MichalBiro/Bachelor-thesis/README.md

# Bachelor-thesis

This repository serves for storing and sharing my bachelor thesis files.

DipTrace
- in this folder you can find schemes for my hardware PCBs made in CAD software DipTrace

Latex
- this folder contains all files of wich consists my Bachelor thesis.
- look for Zaverečná_práca.pdf to read my thesis
