MichalBiro/Bachelor-thesis/Latex/Obalka.tex

\renewcommand\thepage{\roman{page}}
\pagenumbering{roman}
\thispagestyle{empty}

\noindent \begin{center}
	\textbf{{\large{}SLOVENSKÁ TECHNICKÁ UNIVERZITA V BRATISLAVE}}\\
	\textbf{{\large{}STROJNÍCKA FAKULTA}}\textbf{\large{} }\\
	\vspace{3cm}
	\par\end{center}

\noindent \begin{center}
	\vspace{3cm}
	\par\end{center}

\begin{center}
	\textbf{\textsc{\Large{}BoBShield: Miniaturizovaný experiment „guľôčka na tyči“}}\\
	\par\end{center}{\Large \par}

\begin{center}
	\textbf{\large{}Bakalárska práca}\\
	\par\end{center}{\large \par}

\begin{center}
	{\large{}SjF-13432-104853}\\
	\par\end{center}{\large \par}

\vfill
\noindent \textbf{\large{}2022} \hfill \textbf{\large{}Michal Bíro}
\cleardoublepage
