MichalBiro/Bachelor-thesis/Latex/Zaverečná práca.pdf

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

Názov práce: Miniaturizovaný experiment "gu©ô£ka na ty£i"
K©ú£ové slová: - Arduino, ToF, servomotor gu©ô£ka na ty£i, riadenie Abstrakt: Cie©om bakalárskej práce je vylep²enie existujúceho zariadenia BOBShield, ktoré reprezentuje experiment s názvom gulô£ka na ty£i a je sú-£as´ou projektu AutomationShield. V prvej kapitole rozoberá samotný experiment a opisuje pôvodné verzie zariadenia. V druhej kapitole hovorí o zmenách, ktoré sme na zariadení vykonali, vysvet©uje dôvody, pre£o sme sa pre dané zmeny rozhodli a ukazuje výsledný model ná²ho zariadenia. V poslednej kapitole sa venuje softvérovej £asti zariadenia, kde hovorí o API v programoch Simulink a Arduino IDE, ktoré sme pre zariadenie upravili alebo vytvorili a príkladoch, ktoré sme testovali na novom hardvéry. V závere hovorí o priestore na zlep²enie daného zariadenia v budúcnosti.

Title: Force measurement by strain gauges
Keywords: - Arduino, ToF, servomotor, ball on beam, control
Abstract: The aim of this bachelor thesis is to improve the existing BOBshield device, which represents an experiment called ball on beam and is part of the AutomationShield project. In the rst chapter analyze the experiment itself and describes older versions of the device. In next chapter talks about the changes we have made to the device, explains the reasons for their implementation and shows the nal model of our device. The last chapter deals with the software of device, which consists of APIs made in programming environments Simulink and Arduino IDE and examples made in these environments, which were tested on the new hardware. At the end it talks about possible improvements that can be made to the device in the future and outcomes of this thesis.

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

## Úvod

Oblas´ automatizácie a automatického riadenia sa rýchlo rozvíja a v modernom svete má ve©ké zastúpenie v oblasti výroby. Vo svete sú £oraz viac vyuºívané automatické výrobné linky, prevádzky a závody, práve kvôli zvy²ovaniu produktivity a redukciou vznikajúcich chýb vo výrobe. Aby mohol rozvoj napredova´ je potrebné pre danú oblas´ podporova´ vzdelávanie budúcich technikov a vedcov. Práve kvalita vzdelávania sa totiº výrazne odrazí v nasledujúcich rokoch ich práce.
Hoci dôleºitou £as´ou vzdelávania je práve teória riadenia, s ktorou sa ²tudenti univerzít stretávajú na predná²kach, platí, ºe £lovek si najviac zapamätá, ke¤ si to môºe aj vyskú²a´ v praxi. Nie kaºdý má v²ak túto moºnos´ a nie kaºdá univerzita disponuje rovnako vybavenými laboratóriami. Preto je pre mnohých niekedy takmer nemoºné stretnú´ sa po£as ²túdia s praxou a to hlavne v £asoch, kedy sa ²tudenti nemôºu zú£astni´ prezen£nej vzdelávacej formy. Absencia praktických ukáºok môºe ma´ za následok neskor²ie problémy pri prechode ²tudentov na pracovný trh.
AutomationShield so svojimi zariadeniami priná²a jednoduché rie²enie tohto problému, kedy tvorbou zariadení minimálnych rozmerov a nákladov, poskytuje ²tudentom moºnos´ vyskú²a´ si riadenie systému v praxi. V¤aka svojej cene nie sú pre ²kolu tieto zariadenia nan£ne náro£né a svojimi ²ikovnými rozmermi poskytujú ²tudentom moºnos´ pracova´ na nich aj z domova., £o je viac ako vítané pri di²tan£nej forme ²túdia. Momentálne sa v projekte nachádza 11 zariadení a BOBShield je jedným z nich. Zariadenie uº pre²lo ur£itým vývojom a momentálne existujú 2 verzie. Hoci pri druhom zariadení pri²lo ku viacerým zmenám a vylep²eniam oproti prvej verzii, stále poskytuje priestor na vylep²enie. Cie©om práce bolo opä´ urobi´ analýzu zariadenia a prís´ s nápadmi na vylep²enie, £i uº hardvéru alebo softvéru. V oblasti softvéru i²lo o vývoj API v programovacom prostredí Simulink a tvorba príkladu na riadenie systému. Pri hardvéry sme sa zamerali na pouºité komponenty, kde sme h©adali ich varianty, nachádzajúce sa na trhu a analyzovali sme ako by ich zmena vplývala na chod zariadenia.
Túto tému som si vybral hlavne z dôvodu . Tieº povaºujem celú my²lienku AutomationShieldu ve©mi efektívnu a praktickú. Pá£i sa mi snaha poskytnú´ ²tudentom priestor pre rozvoj a vzdelávanie nie len v teoretickej rovine ale aj v praxi. Hoci ide o v princípe jednoduché zariadenia, kaºdé má ve©ký potenciál a proces vývoja a vylep²ovania jednotlivých verzií a prevedení so sebou priná²a taktieº drahocenné skúsenosti a vedomosti.

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

mov. Medzi programy vyuºívané pre tvorbu API - rozhraní pre programovanie aplikácií patrí v základe Arduino IDE, MATLAB a Simulink.

## 1.2 Experiment - Gulô£ka na ty£i

Guli£ka na ty£i po anglicky Ball on Beam, odkia© pochádza aj názov ná²ho zariadenie, je dynamický systém, ktorý pozostáva z dlhej ty£e pripojenej k servomotoru, ktorá sa jeho pôsobením naklá¬a a guli£ky, ktorá sa pohybuje po ty£i dopredu a dozadu, v závislosti od jej naklonenia. Ide o ve©mi populárny príklad pouºívaný pri výu£be teórie riadenia. Guli£ka na ty£i je teda nestabilný, nelineárny systém s otvorenou slu£kou. Aj pri malej výchylke trubi£ky sa guli£ka skotú©a do jednej z krajných polôh ty£e. Stabilizáciu guli£ky v ur-£itej pozícii je potrebný riadiaci systém, ktorý meria polohu guli£ky na ty£i a na základe získaných hodnôt vyhodnocuje nastavenie polohy ty£e. Na obrázku 1.1 môºeme vidie´ parametre systému, kde zmena uhla θ pôsobí cez rameno páky na ty£ a spôsobí jej oto£enia o uhol α. Ke¤ sa zmení uhol z horizontálnej pozície, gravitácia zaprí£iní pohyb guli£ky po ty£i. Úlohou riadiaceho systému je teda aby sme vedeli ovláda´ pozíciu guli£ky.

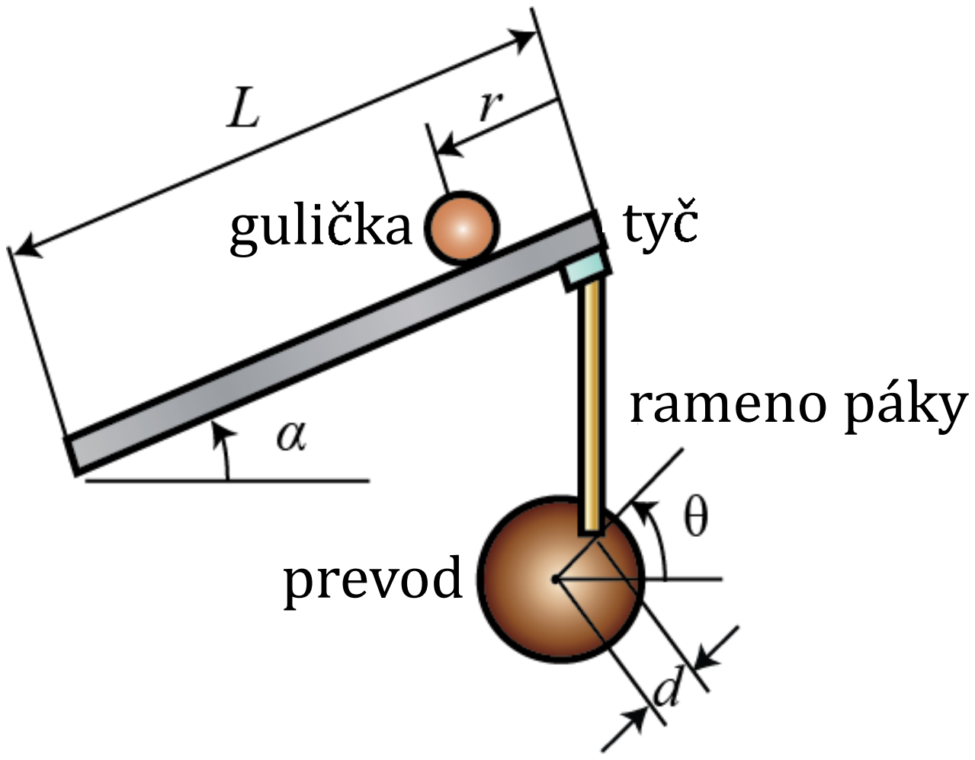
[picture p4: figure]
guli ka; rameno páky; prevod

Obr. 1.1: Systém guli£ka na ty£i [5]

Ná² systém sa od systému na obrázku mierne lí²i. Namieste ty£e sa guli£ka pohybuje uprostred trubi£ky a jej stred otá£ania sa nenachádza na konci trubi£ky ako to môºeme vidie´ na obr. 1.1. Uloºená je v drºiaku, ktorý sa nachádza v jej strede a práve pomocou neho je na ¬u prená²aný krútiaci moment zo servomotora. V pôvodnej verzii sa teda nenachádzal ani prevod spomenutý na obrázku, drºiak bol priamo pripevnený k servomotoru. Prevod sme v²ak pri vylep²ovaní hardvéru zahrnuli do jeho zmien, no oproti klasickému rie²eniu uvedenému na obrázku sme zvolil ná² vlastný originálny prístup. Výhodnou tohto spôsobu zostavenia systému sú jeho rozmery, sú dostato£ne malé aby sme vedeli celý model uloºi´ na Arduino shield.

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

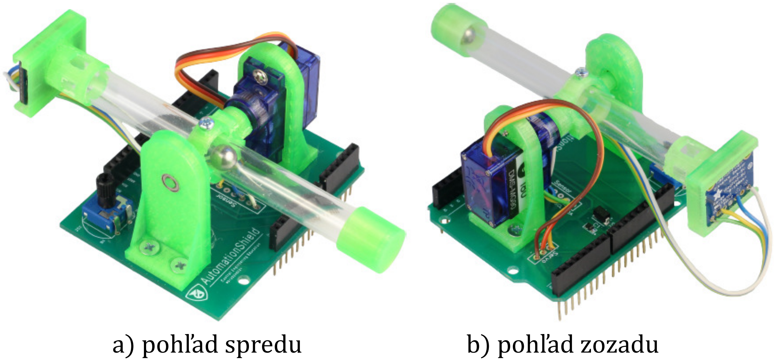
[picture p5: figure]
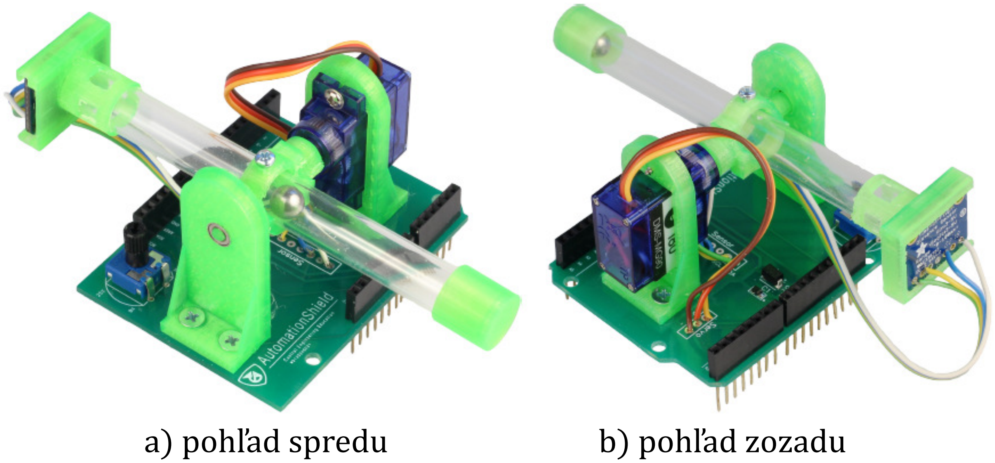
[picture p6: figure]

vytvorené API (aplika£né programovacie prostredie) len v prostredí Arduino IDE. Pozostáva z kniºnice BOBShield.h a nieko©kých príkladov ako je regulácia alebo identikácia systému. To ponúka priestor pre tvorbu nových API v uº spomenutých programovacích prostrediach.

### 1.3.2 R2 hardvér

Z h©adiska hardvéru ponúka verzia R2 priestor pre analýzu pouºitých komponentov a ich porovnanie s novými moºnos´ami ponúkanými na trhu. Tieº je moºné zvý²enie presnosti otá£ania trubi£ky o implementáciou uº spomínaného prevodu medzi servomotorom a drºiakom trubi£ky. Z toho následne vyplýva aj zmena 3D prvkov a celkového dizajnu zariadenia.

## 2 R3 hardvér

Nasledujúca kapitola je venovaná vyhotoveniu zariadenie z poh©adu hardvéru. Hovorí o £astiach, z ktorých sa zariadenie skladá, o ich parametroch, funkciách a vlastnostiach. Taktieº porovnáva poslednú verziu vyhotovenia verzia R3, so star²ími verziami zariadenia, vysvet©uje, pre£o sme sa pre dané zmeny rozhodli a ako vplývajú na celkové fungovanie zariadenia. Medzi výraznej²ie zmeny patrí napríklad implementácia nového sníma£a - gyroskopa alebo nový typ prevodového systému. Kapitola najprv vysvet©uje schému zapojenia ná²ho zariadenia, neskôr detailnej²ie opisuje jednotlivé komponenty, z ktorých sa zariadenie skladá. Tieº opisuje výber vhodného telesa pre ná² systém, implementáciu nového spôsobu prevodu rota£ného pohybu zo servomotora na trubi£ku a tvorbu nových 3D prvkov. V závere sa nachádza zoznam v²etkých komponentov a sú£iastok, z ktorých sa zariadenie skladá a hovorí o jeho výslednej cene.

## 2.1 Schéma zapojenia

Schéma zapojenia ná²ho zariadenia pre²la od poslednej verzie nieko©kými zmenami. Celkovo by sa dala rozdeli´ na 2 oddelené schémy, ktoré sú vzájomne prepojené pomocou FFC (at exible cable) káblu. Oddelenie schém je potrebné z dôvodu, ºe senzory na snímanie polohy guli£ky v trubi£ke a pooto£enia ramena musia by´ umiestnené na trubi£ke. Z toho vyplýva ºe schéma celého na²eho zariadenia musí by´ oddelená aby mohli by´ vytvorené 2 PCB dosky, ktoré v celku tvoria jednu schému. Prvou je £as´ zariadenia nachádzajúca sa na hlavnej PCB doske (obr. 2.1 ), ktorú priamo zapájame do Arduina. Obsahuje servomotor (a) , ktorý je napájaný 5 V a je pripojený k arduinu () prostredníctvom pinu 9, cez ktorý prijíma od arduina PWM signál, potrebný na riadenie polohy oto£enia jeho hriade©a. K servomotoru je pripojený aj kondenzátor
(g) a dióda (j). Úlohou kondenzátora je vyhladi´ prechodové javy, ktoré by mohli ovplyvni´ napájanie serva a dióda slúºi ako ochrana pred po²kodením obvodov spätným EMF elektromotorickým napätím. Potenciometer (c) je napájaný napätím 3,3 V a k arduinu je pripojený pomocou analógového pinu A0, ktorý slúºi na získavanie hodnôt, ktoré neskôr transformujeme do formy, v ktorej môºu by´ pouºité ako referen£ná hodnota pre riadenie polohy. Zmenou v schéme zapojenia oproti poslednej verzii je implementácia lineárneho regulátora napätia LDO (b), potrebného pre zmenu hladiny napätia pre napájanie sníma£ov. Je pripojený k zdroju napätia o ve©kosti 5V, ktorého hladinu upravuje a uº zmenenú posiela na konektor pre FFC kábel (d). Ten slúºi na

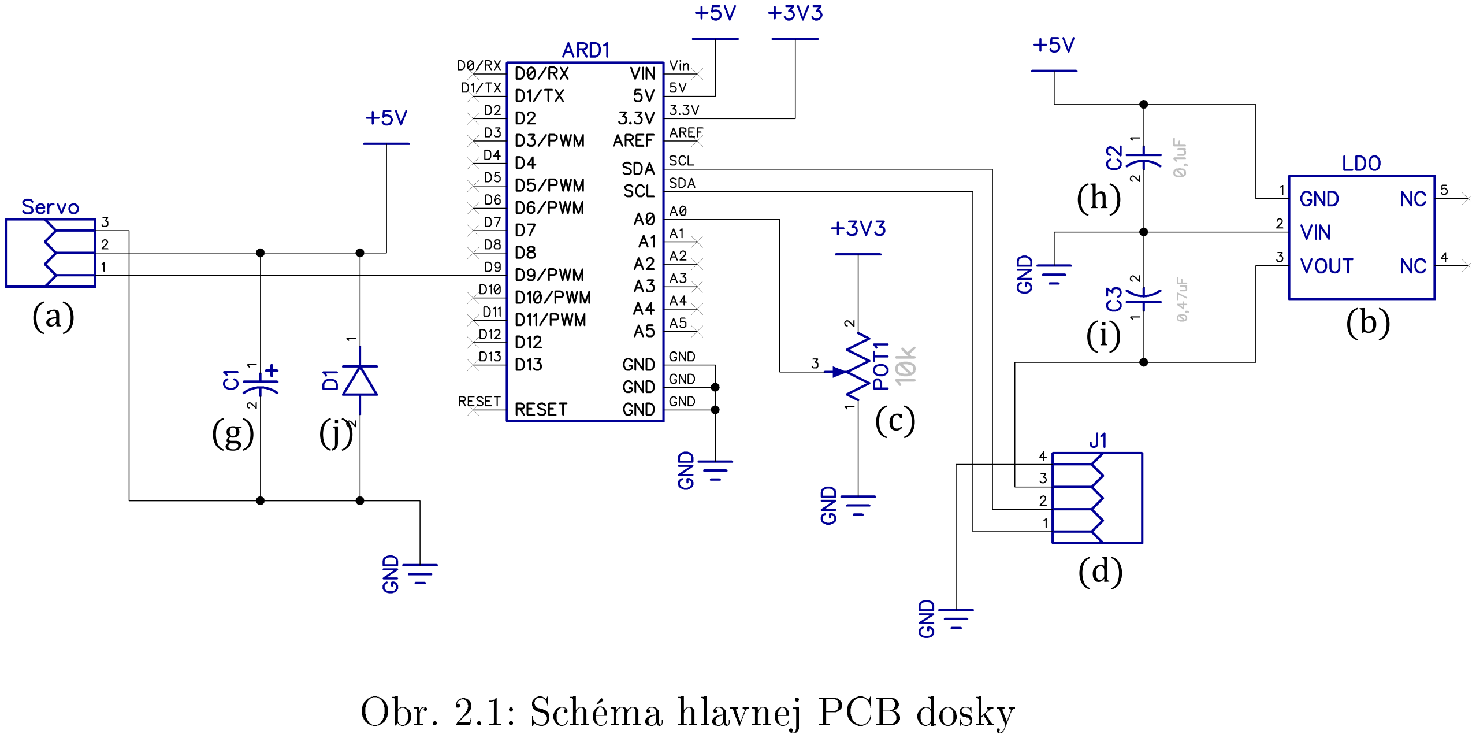
[picture p7: figure]
(j)Obr. 2.1: Schéma hlavnej PCB dosky

prepojenie jednotlivých schém do jedného celku. Je pripojený k pinom SCL a SDA na arduine, ktoré slúºia na sprostredkovanie I2C komunkácie. Ku LDO sú paralelne pripojené 2 kondenzátory (h) (i), ktoré sú na základe informácii z datasheetu [] potrebné pre fungovanie LDO a ich parametre sú pre daný lineárny regulátor napätia zadané.
Druhá £as´ schémy (obr. 2.2 ) je nami navrhnutá breakout doska, nachádzajúca sa na konci trubi£ky a obsahuje na²e sníma£e. Sníma£ polohy VL6180X
(e) je pripojený ku konektoru (d), ktorý mu poskytuje napájacie napätie a taktieº sprostredkováva I2C komunikáciu medzi sníma£om a arduinom. Gyroskop MPU-6050 (f) je rovnako ako sníma£ polohy napájaný cez konektor (d) a taktieº je paralelne pripojený k 2 kondenzátorom (k) (l). Ich potreba vyplýva z informácii poskytnutých v datasheete [], kde je uvedený správny spôsob zapojenia sníma£a aj parametre kondenzátorov. Rezistory (m) (n) slúºia ako pull up rezistory pri I2C komunikácii sníma£ov s arduinom.
Obe schémy boli navrhnuté vo vo©ne dostupnom software DIPTrace.
Po návrhu schémy zapojenia jednotlivých dosiek sme pristúpili k ich fyzickému návrhu. Pri tvorbe hlavnej PCB dosky sme museli pracova´ s tvarom dosky shieldu pre arduino, na ktorú sme sa snaºili vhodne umiestni´ jednotlivé komponenty a konektory. Na hlavnej doske (obr.2.3 a obr.2.4) sa okrem elektronických komponentov budú nachádza´ aj 3D prvky zariadenia, preto treba po£íta´ aj s ich umiestnením a vhodne zvoli´ diery ur£ené pre montáº týchto prvkov k doske (o). Na doske sa teda nachádza spoj pre pripojenie servomotora
(a) a potenciometer pre získavanie referen£nej hodnoty (c), ktorých umiestnenie sme nechali v rovnakej polohe ako pri pôvodnej verzii dosky. Ich poloha je vzh©adom na umiestnenie 3D prvkov ideálna, ke¤ºe konektor servomotora sa nachádza v dostato£nej blízkosti pre jeho pripojenie a zárove¬ nemusíme pouºi´ zbyto£ne dlhý kábel. Potenciometer sa tieº vzh©adom ku 3D modelu nachádza vo vhodnej pozícii, ke¤ºe jeho umiestnenie je ovplyvnené práve potrebou moºnosti pohybova´ s beºcom po£as chodu zariadenia. Preto je potrebné aby nedochádzalo k vzájomnej interakcii medzi pohyblivými £as´ami zariadenia

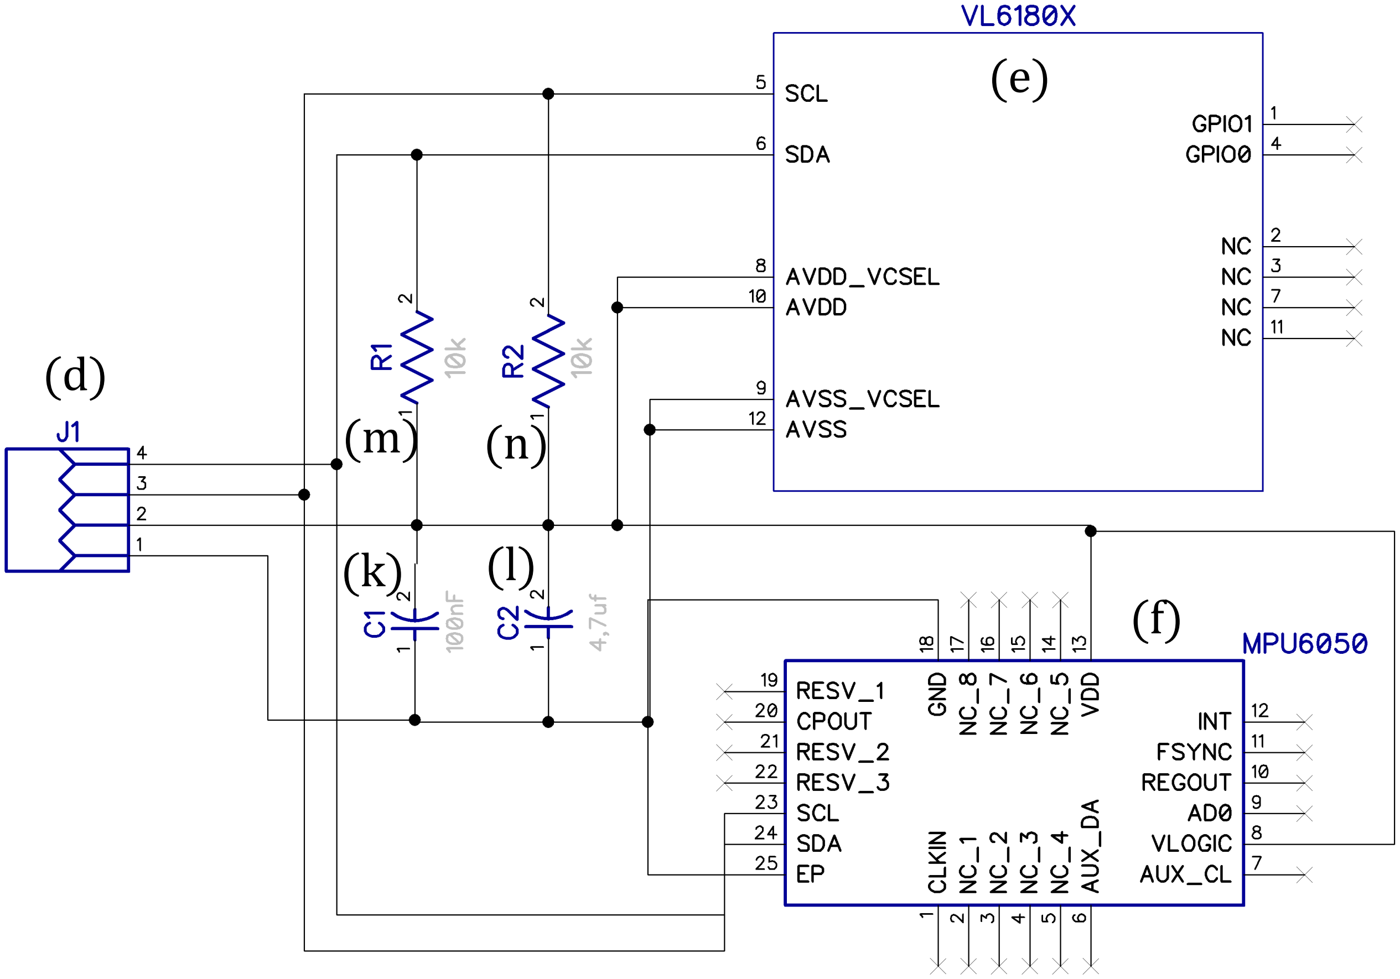
[picture p8: figure]

Obr. 2.2: Schéma PCB dosky so sníma£mi

a rukou uºívate©a pri nastavovaní referen£nej hodnoty. Umiestnenie kondenzátora (g) a diódy (i) je tieº pod©a pôvodnej verzii. Umiestnenie konektoru pre FFC káble (d) sme zvolili tak, aby sa po montáºi kompletného zariadenia nachádzal pod trubi£kou a tak nedochádzalo k jeho zahnutiu a sp¨¬alo to aj estetickú funkciu. Na základe jeho pozície do²lo k umiestneniu spoja pre LDO (b), ke¤ºe jeho úlohou je zmena hladiny napätia do rozsahu napájacích napätí sníma£ov, nachádza sa medzi konektorom FFC kábla (d) a zdrojom napätia z arduina. Kondenzátory (h) (i), na základe informácií z datasheetu [] potrebné pre fungovanie LDO, sú umiestnené v jeho tesnej blízkosti ako je odporú£ané. Pri návrhu PCB dosky ur£enej pre sníma£e (obr. 2.5), sme neboli obmedzení ºiadnym konkrétnym tvarom dosky, preto bolo na²im cie©om dosiahnu´ rozloºenie jednotlivých komponentov optimálnym spôsobom aby sme dosiahli £o najmen²ie rozmery. Na hornej £asti dosky môºeme nájs´ plo²ný spoj pre umiestnenie sníma£a MPU-6050 (f), konektor pre pripojenie FFC kábla (d) a jednotlivé komponenty (g) (h) (i) (j), ktorých implementácia vyplýva zo schémy zapojenia jednotlivých sníma£ov, ktorú je moºné nájs´ v datasheetoch []. Na spodnej strane PCB dosky sa nachádza spoj pre umiestnenie sníma£a VL6180X (e). Umiestnenie sníma£a na spodnej strane je z dôvodu aby smeroval do vnútra trubi£ky, v ktorej sa nachádza guli£ka. Po umiestnení PCB dosky do drºiaka na konci trubi£ky, sníma£ VL6180X smeruje do vnútra trubi£ky a z naopak FFC kábel smeruje von z trubi£ky, £o poskytuje jeho jednoduchú montáº.

## 2.2 Komponenty

Nasledujúca podkapitola detailnej²ie opisuje vlastnosti komponentov, s ktorými sme sa uº stretli pri schéme zapojenia. Hovorí o ich parametroch, funkciách, ktoré v zariadení zastre²ujú a tieº opisuje proces ich výberu a dôvod

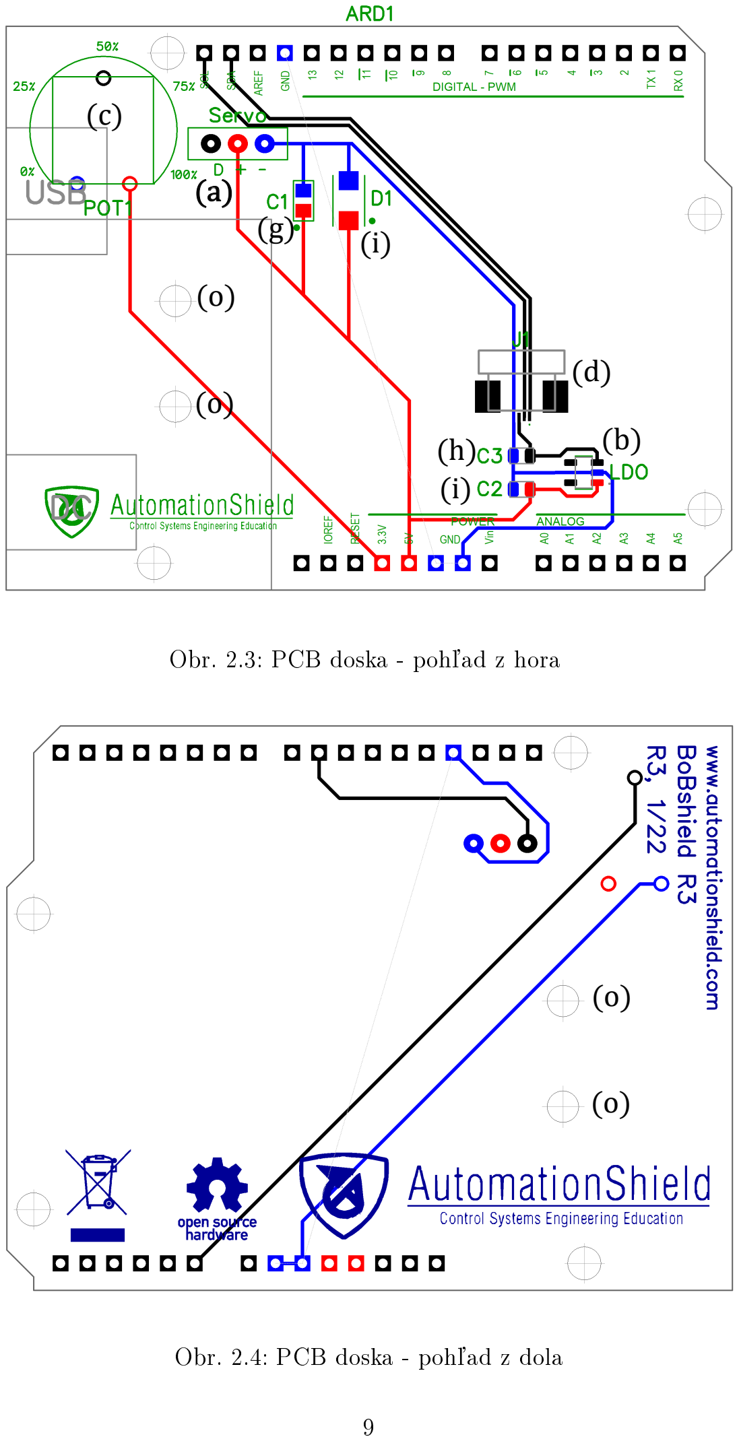
[picture p9: page 16]

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
Obr. 2.3: PCB doska - poh©ad z hora

(o)

(o)

Obr. 2.4: PCB doska - poh©ad z dola

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

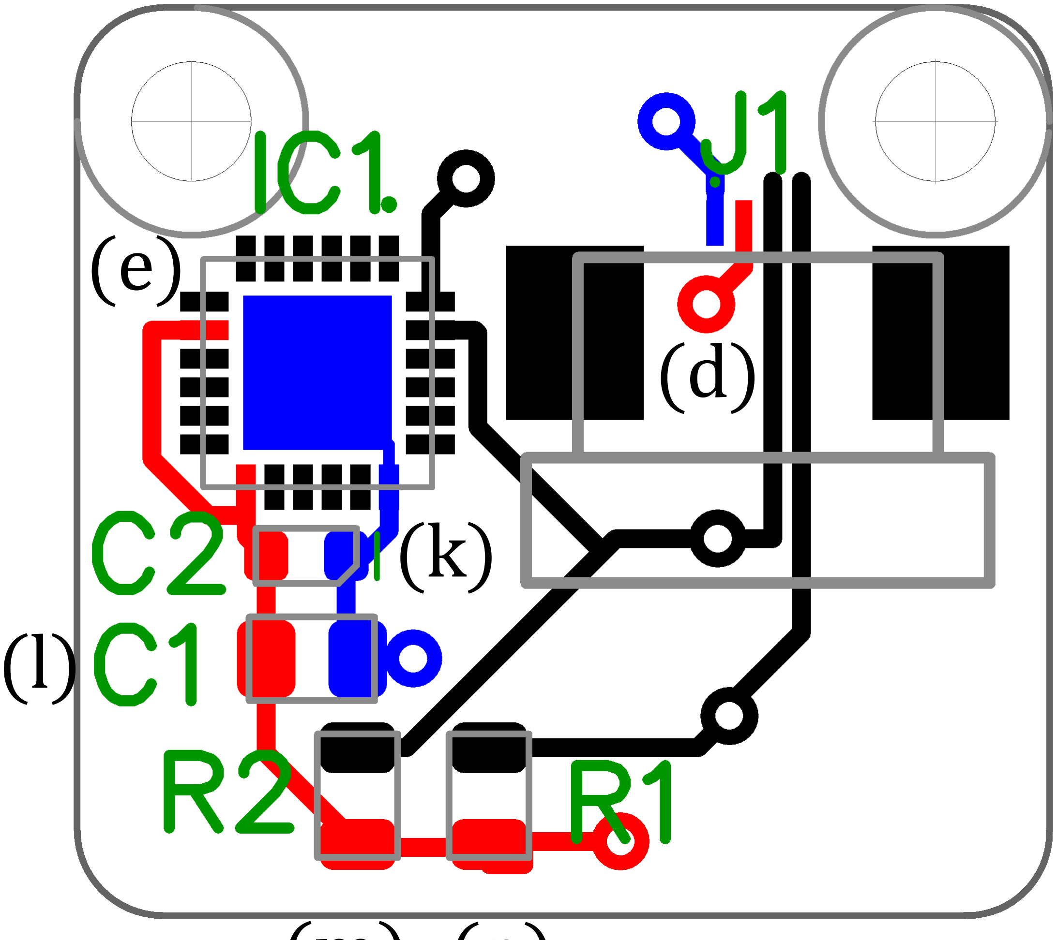
[picture p10: figure]
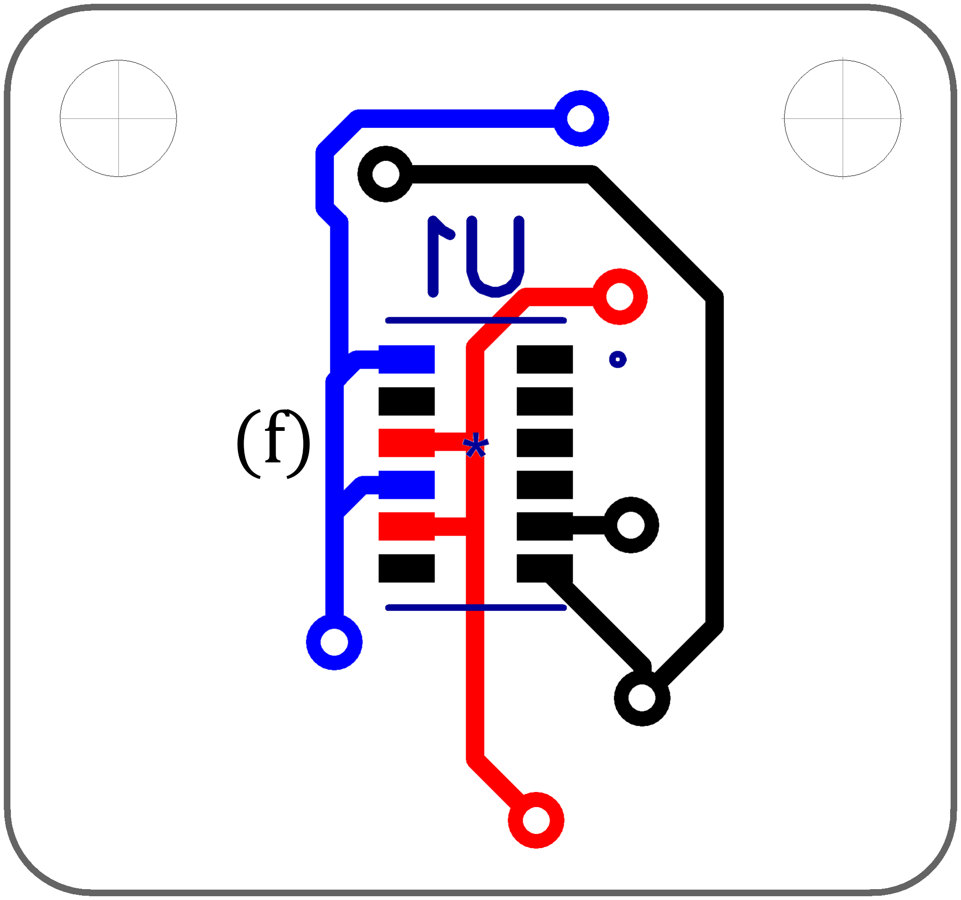
[picture p11: figure]

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

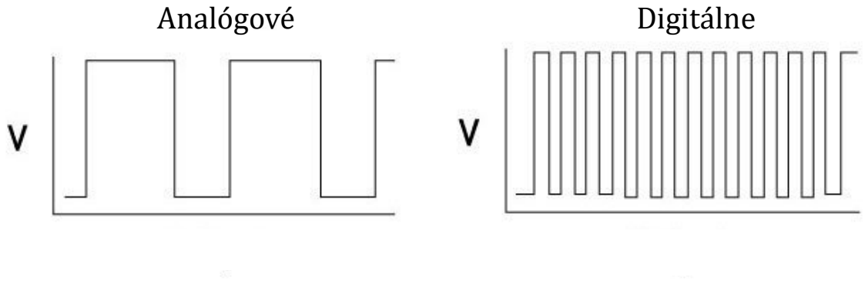
[picture p12: figure]
Analógové; Digitálne

Obr. 2.6: D¨ºka cyklu PWM signálu pre analógové a digitálne servo

Typ: Digitálne

prevody: Kovové

cena: 16 eur

### 2.2.2 ToF sníma£ - VL6180X

Úlohou sníma£a je sníma´ polohu guli£ky v trubi£ke a dáta posiela´ mikropo-£íta£u. Poskytuje nám aktuálnu hodnotu vzdialenosti, ktorá sa porovnáva s poºadovanou na základe £oho regulátor vypo£íta hodnotu ak£ného zásahu do systému.
Pri sníma£i vzdialenosti sme sa rozhodli osta´ pri pôvodnej vo©be typu a modelu, ktorým je VL6180X (obr. 2.8). Ide o ToF sníma£, ktorý meria vzdialenos´ na základe vysielania, odrazu a následného prijímania svetelného lú£a. Princíp fungovanie(obr. 2.7) je zaloºený na meraní £asu, za ktorý svetelný lú£ vyslaný zo sníma£a doletí k telesu, ktorého pozíciu meriame, odrazí sa od neho a vráti sa spä´. Na základe rovnice (rov. 2.1), kde c - predstavuje rýchlos´ svetla, ∆T £as, ktorý trvá lú£u odraz a návrat k sníma£u, samotný sníma£ vypo£íta vzdialenos´ - x , v ktorej sa nachádza teleso od sníma£a. Komunikácia s arduinom prebieha prostredníctvom I2C protokolu. Rozsah napájacieho napätia je 2,6V 3,0V.
2x = c ∗ ∆T | (2.1)

Hoci sme zvaºovali aj iné typy sníma£ov vzdialenosti ako napríklad ultrazvukové alebo IR (infra£ervené) sníma£e, pri²li sme k záveru, ºe najvhodnej²ím typom sníma£a bude práve ToF v¤aka jeho malým rozmerom. Z moºností ToF sníma£ov ponúkaných na trhu je pre na²e zadanie VL6180X momentálne ideálnou moºnos´ou z dôvodu:

odrazený lú | vyslaný lú

# ToF

X

Obr. 2.7: Princíp fungovania ToF senzora

merate©ného rozsahu - 100 mm

presnosti merania - na 1 mm

malým rozmerom 4.8 x 2.8 x 1.0 mm [1]

Merate©ný rozsah sníma£a je pre nás úplne posta£ujúci, ke¤ºe guli£ka sa pohybuje v trubi£ke práve o d¨ºke 100 mm, s tým ºe v koncových bodoch sa nachádzajú e²te uzavretia trubi£ky, takºe rozsah pohybu guli£ky je pribliºne 90 mm, £o nám dáva e²te ur£itú rezervu. Dokonca ve©a sníma£ov nesp¨¬a na²e poºiadavky práve z dôvodu ºe ich merate©ný rozsah neza£ína v 0 mm ale aº pri vy²²ích hodnotách. Hoci presnos´ meranie na 1 mm nie je pre riadenie systému ideálna, z ponúkaných senzorov sa nám nepodarilo v danej kategórii nájs´ ºiadny s lep²ou presnos´ou. Rozmery sú pre nás dôleºité z h©adiska potreby umiestnenia sníma£a do jednej z koncových polôh trubi£ky aby sme mohli mera´ pozíciu guli£ky. Taktieº príli² ve©ké rozmery ako napríklad pri ultrazvukovom sníma£i by pre minimálne rozmery ná²ho zariadenia neboli vhodné z hladiska estetickosti. V¤aka minimálnym rozmerom sníma£a sa nám oproti pôvodnej verzii podarilo zmen²i´ diel upevnenia sníma£a na trubi£ke, £ím sme zlep²ili aj estetickú zloºku zariadenia.
Na obrázku 2.9 môºeme vidie´ schému zapojenia sníma£a uvedenú v datasheete. V na²ej aplikácii sme piny 1 a 4 (GPI01 a GPIO0) nepouºívali a nechali sme ich vo©né. Piny 5 a 6 SCL a SDA, slúºiace na I2C komunikáciu sníma£a s mikropo£íta£om sú pomocou pull up rezistorov pripojené k napätiu. Za hodnoty pull up rezistorov sme zvolili odpor 10 kW. Ako môºeme vidie´ v schéme piny 9 a 12 sú uzemnené a piny 10 a 8 sú zase pripojené k napájaniu, pri£om sú k nim paralelne pripojené 2 kapacitory, ktorých hodnota je uvedená

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

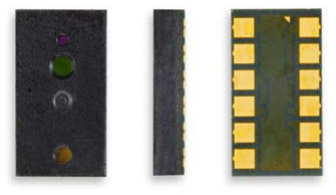
[picture p13: figure]
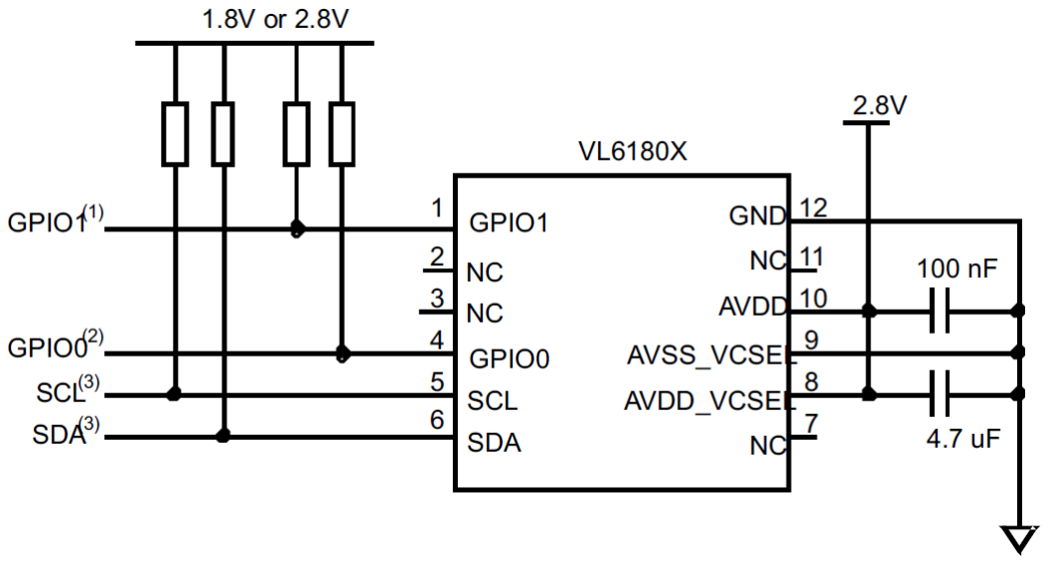
[picture p14: figure]

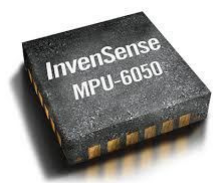
[picture p15: figure]

Obr. 2.10: Schéma zapojenia sníma£a

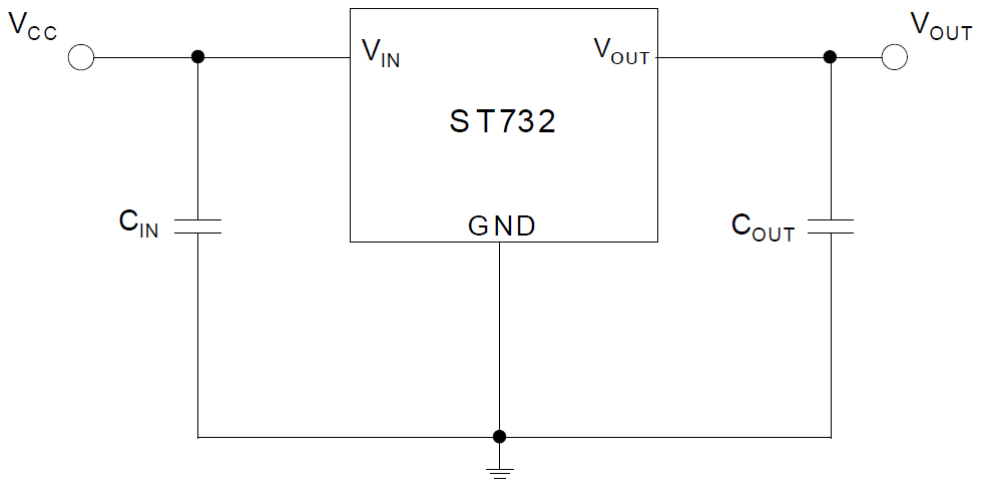
[picture p16: figure]

Obr. 2.11: Schéma zapojenia sníma£a[3]

### 2.2.4 Lineárny regulátor napätia - LDO

Z dôvodu tvorby vlastného braekoutu, na ktorom sú umiestnené oba na²e sníma£e bolo potrebné nájs´ vhodné napájacie napätie aby vyhovovalo obom sníma£om a spadalo do ich rozsahov napätí. Pre sníma£ VL6180X je vstupné napätia v rozmedzí 2,6 V - 3,0 V [1] a pri MPU6050 ide o rozsah 2,375 3,46 V[2]. Arduino nám ponúka len 2 úrovne napájania a to 3,3 V a 5 V. Ak by sme vyuºívali len sníma£ MPU6050 mohli by sme priamo vyuºi´ napájanie 3,3 V, ktoré spadá do jeho pracovného rozsahu, no pre sníma£ polohy je táto moºnos´ nevyhovujúca. Preto je potrebné upravi´ ponúkané úrovne napätia z arduino dosky do rozsahu 2,6 - 3,0 V, vyhovujúcemu obom sníma£om. O zmenu napätia sa stará lineárny regulátor napätia STM732M28R od rmy STMicroelectronics , ktorý vstupné napätie v rozsahu 2,5 28 V prevádza na úrove¬ 2,8 V. Táto hladina je vyhovujúca pre oba sníma£e.

## 2.3 Teleso

Dôleºitou £as´ou celého systému je práve guli£ka, pohybujúca sa v trubi£ke, ktorej polohu sledujeme a riadime. Na ná² systém vplýva ako jej hmotnos´ a tvar tak aj kvalita a farba jej povrchu. Ke¤ºe na meranie polohy guli£ky pouºívame ToF sníma£, ktorý meria vzdialenos´ na základe £asu, za ktorý sa

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

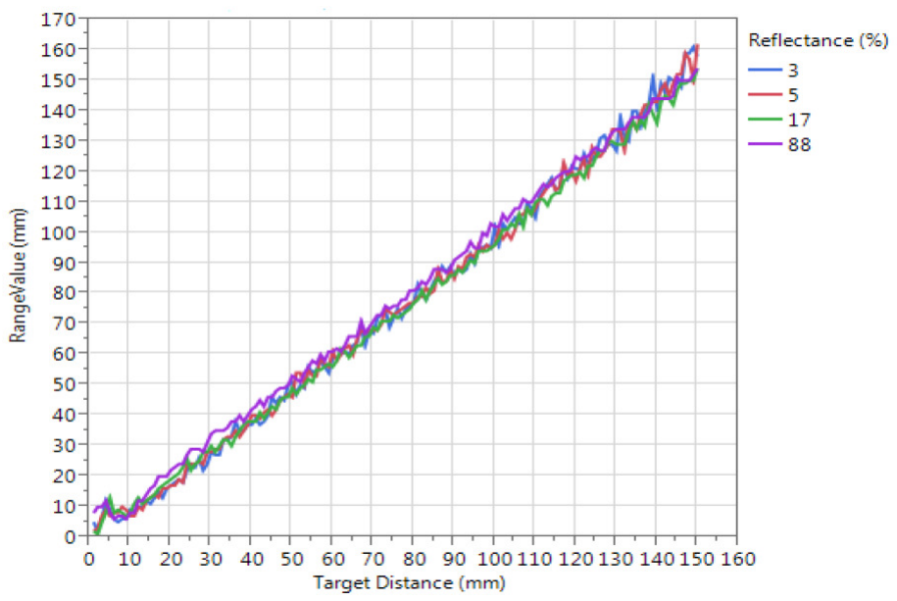
[picture p17: figure]

zmerali 100 hodnôt jej aktuálnej polohy. Hodnoty sme vloºili do tabu©ky a pomocou vzorca 2.2 sme vypo£ítali smerodajnú odchýlku pre dané meranie.

σ =

vuut
1
N

X

N

i=1

(xi − x¯)

2

(2.2)

Tento postup sme zopakovali pre v²etky materiály. V tabu©ke 2.1 môºeme vidie´ porovnanie smerodajných odchýlok pre jednotlivé materiály. Na základe merania, ktoré sme vykonali, môºeme tvrdi´, ºe ná² sníma£ dosahuje najmen²ie smerodajné odchýlky pri materiály PP polypropylén a najvä£²ie odchýlky
pri NBR syntetická guma.
Materiál | silikón | POM | drevo | NBR | NR | oce© | PP
smerodajná odchýlka | 1,27 | 1,2891 | 1,3644 | 1,6271 | 1,3322 | 1,5 | 1,2595

Tabu©ka 2.1: Smerodajné odchýlky pre dané materiály

Ako bolo vy²²ie spomenuté, dynamika systému má ve©ký vplyv na jeho riadenie. Z toho dôvodu je pri výbere guli£ky dôleºitá práve rýchlos´ akou sa guli£ka v systéme pohybuje. Ak je guli£ka príli² rýchla , riadiaci systém má menej £asu reagova´ na zmenu jej polohy, ktorá sa hlavne pri výraznej zmene referen£nej hodnoty výrazne mení. Ke¤ºe d¨ºka trubi£ky je pomerne malá (100 mm), ak riadiaci systém nedokáºe v£as zareagova´ na zmenu jej polohy bude dochádza´ k nárazom guli£ky do krajných polôh trubi£ky, £o je pri riadení neºiaduci jav. Z toho dôvodu sa snaºíme voli´ guli£ku, ktorej rýchlos´ je adekvátna pre na²u aplikáciu. Rýchlos´ guli£ky je závislá jednak od jej hmotnosti, materiálu, kvality povrchu a rozmerov. Pri meraní sme zaznamenávali polohu guli£ky a £as, v ktorom sa v danej polohe nachádzala. Pohyb guli£ky bol z jednej krajnej polohy trubi£ky do druhej krajnej polohy pri naklonení trubi£ky o uhol 5 ◦
. Následne sme namerané hodnoty vykreslili do grafu (príloha) v programe MATLAB a pomocou jeho analýzy sme na²li £as, za ktorý guli£ka pre²la danú vzdialenos´ trubi£ky. Postupovali sme nasledovne. V grafe sme si na²li body kedy sa guli£ka nachádzala v vzdialenosti 80 mm a 20 mm od sníma£a. Z tabu©ky sme si vypo£ítali za aký £as guli£ka túto vzdialenos´ 60 mm pre²la. Hodnoty sme zapísali do tabu©ky (príloha) a vypo£ítali rýchlos´ jednotlivých guli£iek.
Materiál | silikón | POM | drevo | NBR | NR | oce© | PP
rýchlos´ [m/s] | 0,1348 | 0,1504 | 0,1412 | 0,0917 | 0,1279 | 0,1348 | 0,1412

Tabu©ka 2.2: Rýchlosti guli£iek pre dané materiály

V tabu©ke 2.2 môºeme vidie´ porovnanie rýchlosti jednotlivých guli£iek pri pohybe mierne naklonenou trubi£kou. Najpomal²ie sa pohybujúcou je guli£ka z NBR, ktorá oproti guli£ke z ocele, pouºitej v pôvodných verziách zariadenia dosahuje výrazne niº²ie rýchlosti pohybu v trubi£ke. Na základe vykonaných meraní sme sa rozhodli zvoli´ si za teleso v systéme guli£ku vyrobenú z polypropylénu (PP). Sníma£ dosahuje pri danej guli£ke najpresnej²ie merania, takºe meraná poloha guli£ky sa najviac pribliºuje jej skuto£nej polohe. Meranie s £o najmen²ou smerodajnou odchylkou je pri riadení systému k©ú£ové, no treba uvaºova´ aj dynamiku guli£ky. Z nameraných rýchlostí guli£iek by pre nás bola najvhodnej²ou vo©bou guli£ka z NBR, no jej presnosti merania sú výrazne hor-²ie v porovnaní s guli£kou PP. Tá hoci na základe meraní nedosahuje najlep²ie rýchlosti pre na²u aplikáciu, no napriek tomu sme sa rozhodli zvoli´ si ju, na základe dobrých výsledkov pri smerodajnej odchylke merania. Dobrou vo©bou by mohli by´ aj guli£ky zo silikónu alebo materiálu NR. Tie v²ak nesp¨¬ajú poºiadavky na tvar guli£ky, ke¤ºe pri ich výroba na ich povrchu ostáva stopa po forme, ktorá následne bráni plynulému pohybu guli£ky v trubi£ke.
Ak porovnáme guli£ku z ocele, ktorá je telesom pouºitým v pôvodnej verzii a guli£ky z PP, ktorú sme na základe meraní vybrali, môºeme pozorova´ výrazné zlep²enie merania sníma£a z h©adiska smerodajných odchýlok.

## 2.4 Prevod rota£ného pohybu - servo, trubi£ka

Aktuátorom v na²om zariadení je servo motor, no aby mohol vytvára´ ak£ný zásah (pooto£enie trubi£ky) do systému, ktorým je na²a trubi£ke s guli£kou, musí prís´ ku prenosu rota£nému pohybu.
V pôvodnej verzii zariadenia bol tento prevod rie²ený priamym upevnením trubi£ky na Servo motor, £o znamená, ºe oto£enie trubi£ky sa rovnalo oto£eniu serva o príslu²ný uhol z rozsahu ±30°, ktorý bol stanovený. Najmen²í moºný uhol pooto£enia trubi£ky sa teda rovnal presnosti serva : 1°. Vzh©adom na malé rozmery trubi£ky ide o pomerne ve©ký uhol. Malé moºné rozlí²enie uhlu, o ktorý vieme oto£i´ trubi£ku so sebou priná²a obmedzenia pri riadení systému, kedy ak£ný zásah nemôºe nadobúda´ takú mnoºinu hodnôt. To má za následok neschopnos´ nastavi´ tak presný ak£ný zásah aby sa £o najviac pribliºoval hodnote vypo£ítanej riadiacim systémom.
Na²im rie²ením tohto problému je pouºitie jednoduchého prevodu, cez ktorý budeme prená²a´ rota£ný pohyb serva na trubi£ky. Prevod sa skladá z 2 koliesok rozdielnych priemerov, pri£om jedno je upevnené na servo motor a k druhému je pripevnená trubi£ka. Prenos pohybu z jedného kolieska na druhé je rie²ené pomocou ozubeného reme¬a GT2 o ²írke 6 mm, beºne pouºívanom pri krokových motoroch alebo 3D tla£iar¬ach. Výhodou ná²ho rie²enia je vyuºitie takmer celého rozsahu pohybu ná²ho servo motora. Kým pri pôvodnom zariadení i²lo o vyuºitie rozsahu ±30°z moºných ±90°, v danom rie²ení vyuºívame rozsah ±75°.
Prevodový pomer - p a následne aj rozmery koliesok (d1 - vstupný priemer, d2 - výstupný priemer) sme vypo£ítali na základe vzorcov (2.3) pre výpo£et prevodov, kde najprv zistíme prevodový pomer na základe vstupného a výstupného rozsahu oto£enia. Vzorce sa dajú jednoducho odvodi´ na základe d¨ºky posunutia reme¬a - x, ktorá je na oboch kolieskach vºdy rovnaká. Ide o d¨ºku kruºnicového oblúka, o priemere daného kolieska, ktorého uhol je rovný uhlu oto£enia (obr.2.13). Tento uhol môºeme pri výpo£toch nahradi´ rozsahom otá-£ania jednotlivých koliesok. Za výstupný rozsah sme si zvolili ±15°, pre d¨ºku

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

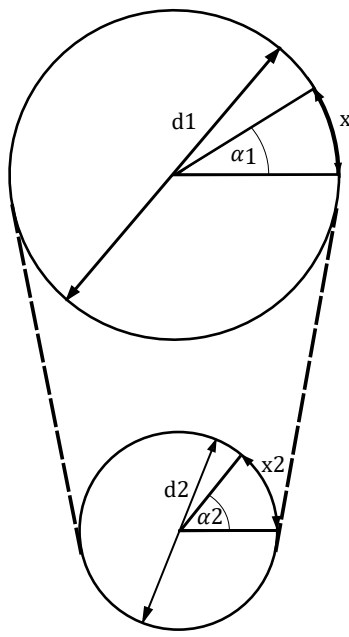
[picture p18: figure]

zásahu do systému. Ak poznáme prevodový pomer rozmery koliesok získame vo©bou priemeru jedného z nich a následným výpo£tom priemeru druhého kolieska na základe vzorca 2.3. Za priemer kolieska pripojeného k servo motoru sme si zvolili d1 = 10mm. Je to dostato£ná ve©kos´ pre uchytenie kolieska a prevod pohybu pomocou reme¬a, no zárove¬ ²etríme miesto aby sme zachovali minimálne rozmery pôvodnej verzie zariadenia. Z toho vyplýva, ºe priemer druhého kolieska bude d2 = 50mm.

## 2.5 3D prvky

Z dôvodu zmeny hardvéru ako je napríklad vytvorenie vlastnej PCB dosky pre sníma£e, do²lo k potrebe návrhu nového 3D modelu zariadenia a aktualizácii jeho star²ích prvkov. Najvýraznej²ou zmenou je pouºitie prevodu (kap.
2.4) na prenos rota£ného pohybu zo serva na trubi£ku. Pre implementáciu tohto prevodu bolo potrebné vytvori´ hne¤ nieko©ko nových 3D prvkov a niektoré star²ie pre²li men²ími zmenami. Tieº sme pri ich návrhu museli h©adie´ na viacero poºiadaviek kladených na tento prevodový systém, ako je potreba moºnosti napínania reme¬a alebo jeho upevnenie na prevodovom koliesku. Na obrázku 2.14 môºeme vidie´ uº výslednú formu 3D modelu zariadenia, ktorá sa skladá z nieko©kých samostatných prvkov, ktorých funkcie si vysvetlíme v tejto sekcii. V²etky prvky boli navrhnuté v CAD programe Fusion 360.

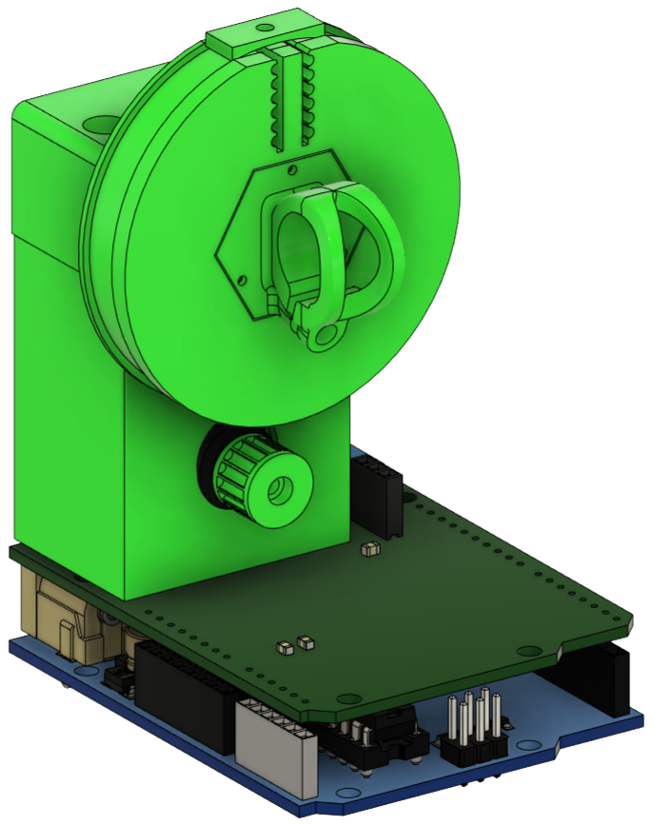
[picture p19: figure]

Obr. 2.14: 3D model zariadenia

Prvým prvkom je diel uloºený priamo na PCB doske, ktorý slúºi na uloºenie servo motora. Môºeme ho vidie´ na obrázku 2.15 a) prvok. Pri umiestnení servo motora v danom diely sme sa snaºili aby sa poloha hriade©a nachádzala v £o moºno najniº²ej polohe aby sme tak ²etrili miesto a minimalizovali rozmery zariadenia. Pripevnenie k prvku je prevedené pomocou závrtných skrutiek. Tieº

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

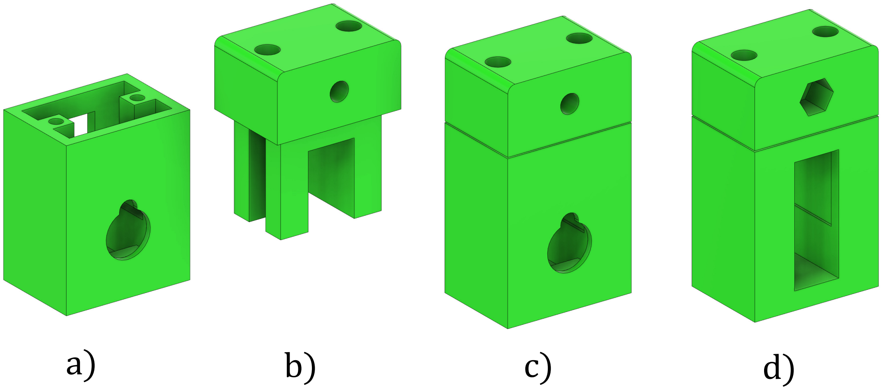
[picture p20: figure]

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

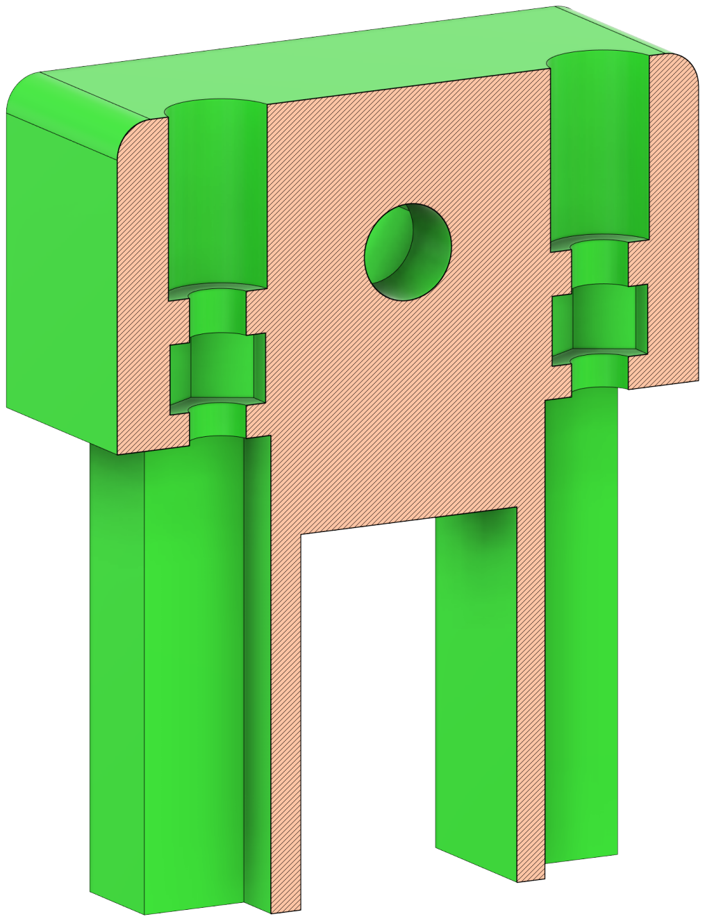
[picture p21: figure]
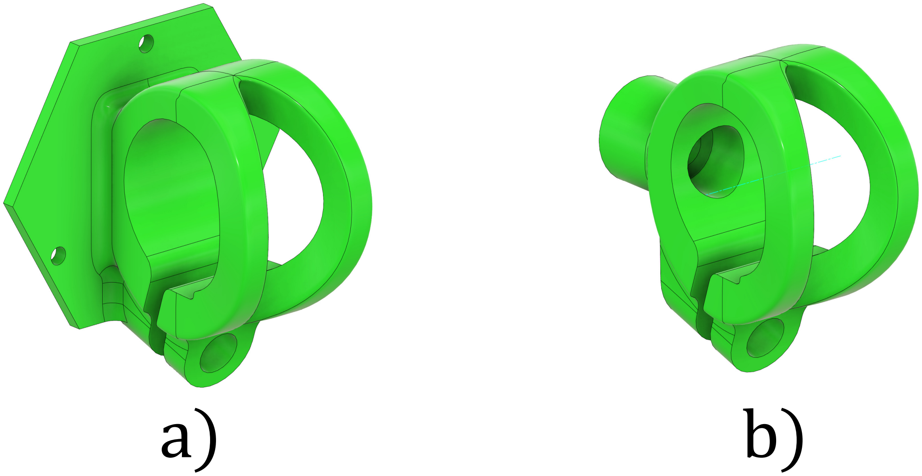
[picture p22: figure]

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

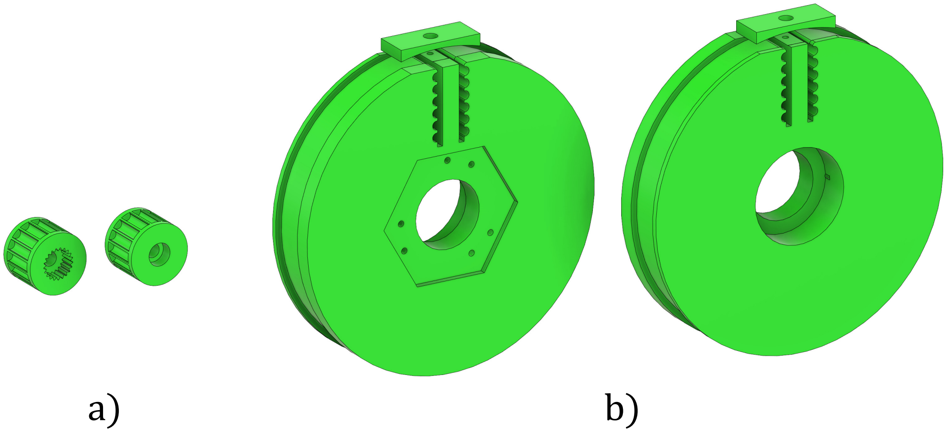
[picture p23: figure]

3 | BoBshield API
3.1 | API pre Arduino IDE
3.1.1 | Filtrácia

Pri meraniach presnosti ToF sníma£a pre rôzne materiály, povrchy a farby guli£iek sme mohli pozorova´ ²um, ktorý nám pri nameraných hodnotách vznikal. Hoci tento neºiaduci jav nie je moºné celkom odstráni´, môºeme jeho dopad na namerané hodnoty výrazne zníºi´ pomocou implementácie jednoduchej ltrácie nameraných hodnôt vhodnou metódou. Pre na²u aplikáciu sme testovali 3 typy ltrácia a to pomocou aritmetického priemeru, aritmetického plávajúceho a váºeného plávavjúceho priemeru. Pri testovaní sme postupovali nasledovne. Základom bolo získanie súboru nameraných hodnôt, na ktorý budeme môc´ aplikova´ ltre a následne navzájom porovna´ ich výstupy. Vstup je pre v²etky typy ltrov identický a preto môºeme spo©ahlivej²ie rozhodnú´ o tom, ktorý z ltrov si zvolíme. Tieto hodnoty vstupu sme získali meraním polohy guli£ky pri jej posune z jednej koncovej polohy trubi£ky k druhej, pri minimálnom naklonení trubi£ky. Hodnoty boli získané a merané e²te na pôvodnej verzii zariadenia BOBShield R2.
Pri aritmetickom priemere sme z ur£itého po£tu nameraných hodnôt urobili aritmetický priemer a výstupom bola 1 hodnota, z £oho vyplýva, ºe frekvencia, s ktorou sme merali je násobne vä£²ia ako frekvencia, získavania ltrovaných hodnôt. To môºe ma´ za následok spomalenie systému z h©adiska rýchlosti reakcie na zmenu polohy guli£ky. Vlastnosti daného typu ltráciu vieme ovplyvni´ po£tom nameraných hodnôt, z ktorých robíme aritmetický priemer. Zvy²ovanie po£tu hodnôt má za následok vä£²ie vyhladenie výslednej krivky, no zárove¬ spôsobuje ur£ité oneskorenie, £o môºe by´ pozorované hlavne ke¤ guli£ka rýchlo mení svoju polohu.
Rozdiel pri plávajúcom aritmetickom priemere je ten, ºe je zaloºený na princípe zberu a ukladaní ur£itého po£tu hodnôt, pri£om pri kaºdom ¤al²om meraní sa nám najstar²ia hodnota vymaºe a pozíciu prvej hodnoty zaujme najnov²ie nameraná hodnota. Z tohto súboru hodnôt sa nám pri kaºdom meraní vypo£íta aritmetický priemer, teda frekvencia merania a frekvencia získavania nameraných hodnôt je identická.
Váºený plávajúci priemer je zaloºený na princípe je zaloºený na rovnakom princípe práce s nameranými hodnotami ako plávajúci aritmetický priemer. Rozdielom je, ºe kaºdá hodnota má inú váhu (ako vyplýva z názvu), teda má rozdielny vplyv na výslednú hodnotu. Výsledná hodnota sa následne vypo£íta pod©a nasledujúceho vzorca:

priemer =

PN
i=1 xi ∗ p(xi)
PN
i=1 p(xi)

=

x1 ∗ p(x1) + x2p(x2) + · · · + xN ∗ p(xN ) p(x1) + p(x2) + · · · + p(xN ) (3.1)

Vlastnosti ltrácie teda vieme ovplyv¬ova´ jednak po£tom hodnôt, z ktorých váºený priemer robíme, ale aj zmenou parametrov ovplyv¬ujúcich váhu jednotlivých hodnôt, teda vplyv na výsledok.
Vzorku hodnôt, na ktorej sme porovnávali vplyv jednotlivých typov ltrov sme si vykreslili do grafu v prostredí MATLAB spolu s grafmi hodnôt získaných po aplikácii ltrov. Následne sme menili parametre ltrov, £i uº i²lo o po£et hodnôt, z ktorých sme tvorili priemer alebo pri váºenom priemere, o nastavenie parametrov váºenia.
Pri procese h©adania parametrov pre váºený priemer sme uvaºovali faktor zabúdania. Ide o bezrozmerné £íslo z intervalu 0 aº 1 a od jeho výberu závisí aké budú parametre jednotlivých váh pre dané hodnoty. Ak si zvolíme faktor zabúdania 0.9, vä£²iu váhu budú ma´ práve star²ie dáta. Naopak ak si zvolíme £íslo blíºiace sa k 0, dôraz bude kladený na najnov²ie hodnoty. Jednotlivé koecienty váh sa na základe faktora zabúdania získajú zo vzorca 3.2, kde λ predstavuje faktor zabúdania. Pre rýchle systémy je lep²ou vo©bou výber men²ích hodnôt faktora.
pn+1 = pn ∗ λ + 1 | (3.2)

Na obrázku 3.1 môºeme vidie´ graf ltrácie pomocou aritmetického priemeru pre rozdielny po£et hodnôt, z ktorých sme priemer získali. Hoci vyhladenie krivky vyzerá ve©mi dobre, oproti plávajúcemu priemeru, hodnoty získavame s ove©a niº²ou frekvenciou, £o vytvára oneskorenie reakcie na rýchlu zmenu polohy guli£ky. Preto je ur£ite vhodnej²ou variantov jeden z typov plávajúcich priemerov.
Na ¤al²om grafe (obr. 3.2 ) môºeme vidie´ ltráciu prostredníctvom plávajúceho aritmetického priemeru. Rovnako sme testovali rôzne po£ty hodnôt z ktorých sme daný priemer robili. Z grafu môºeme vidie´, ºe pri vy²²ích po-£toch hodnôt sa krivka výrazne lep²ie vyhladí, no zárove¬ je na grafe o£ividné oneskorenie oproti neltrovaným dátam. Z daných moºností, ktoré sme testovali sme sa rozhodli pre ltráciu pomocou 5 posledných hodnôt. Krivka dobre kopíruje neltrované dáta z h©adiska oneskorenia a zárove¬ dosahuje prijate©né vyhladenie ²umu.
Na grafe (obr. 3.3 ) vidíme porovnanie ltrácie pomocou plávajúceho váºeného priemeru z 5 hodnôt pre rozdielne faktory zabúdania. Môºeme vidie´, ºe rozdiel medzi jednotlivými krivkami je minimálny. Rozhodli sme sa zvoli´ faktor zabúdania λ = 0.4 , ke¤ºe potrebujeme rýchlu reakciu na zmenu aktuálnej vzdialenosti, £iºe dôraz na posledné hodnoty.

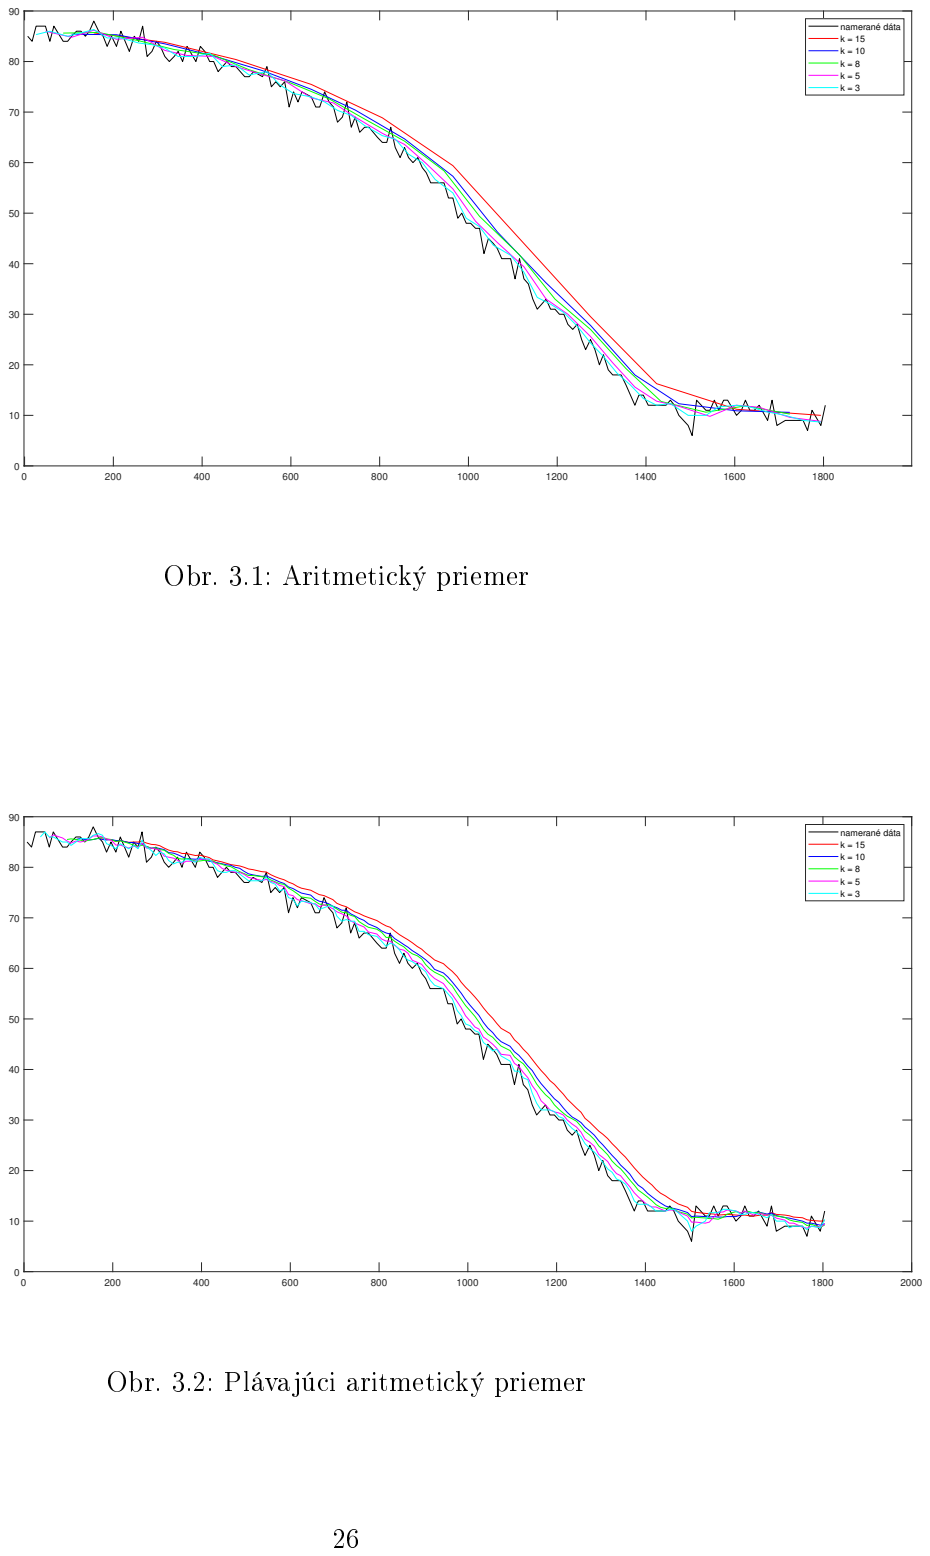
[picture p24: page 33]
namerané dáta

Obr. 3.1: Aritmetický priemer

Obr. 3.2: Plávajúci aritmetický priemer

0 | 200 | 400 | 600 | 800 | 1000 | 1200 | 1400 | 1600 | 1800 | 2000

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
namerané dáta

Obr. 3.3: Plávajúci váºený priemer

Na obrázku 3.4 môºeme vidie´ porovnanie ltrácie plávajúceho aritmetického a váºeného priemeru spolu s pôvodnými, neltrovanými nameranými hodnotami. Môºeme vidie´, ºe rozdiel medzi krivkami je minimálny. Jednoduch²ou vo©bou z h©adiska výpo£tov je ur£ite aritmetický priemer, £ím budeme ²etri´ pamä´ mikropo£íta£a a výsledok bude takmer identický. Z tohto dôvodu sme sa rozhodli pre ltráciu pomocou plávajúceho aritmetického priemeru, po£ítaného z 5 posledných nameraných hodnôt.
Po výbere vhodného ltra pre odstránenie ²umu sme v kniºnici BOBShield.h vytvorili novú funkciu lterSensorRead(). Jej úlohou je teda odstránenie ²umu pri £ítaní hodnôt zo sníma£a a tým zlep²i´ kvalitu riadenia systému.

### 3.1.2 Kniºnica

Zmeny prevedené na hardvéry sa samozrejme odráºajú aj v softvérovej £asti zariadenia. Z toho dôvodu je potrebné upravi´ uº existujúcu kniºnicu BOBShield.h, vytvorenú pre jednoduchú prácu so zariadením, aby bola kompatibilná aj s na-²ou verziou zariadenia.
Prvou vecou, ktorú sme spravili bola tvorba premennej BOB_SHIELD_VERSION denovanej na za£iatku kniºnice. Slúºi pre nastavenie verzie zariadenia, ktorú práve pouºívame. Momentálne v nej môºu by´ nastavené 2 hodnoty a to: 2 pre verziu R2 a 3 pre verziu R3. Túto premennú vyuºívame pri funkciách, ktorých parametre sa pre jednotlivé verzie zariadenia lí²ia ako je napríklad calibration alebo actuatorWrite. Jedná sa teda hlavne o funkcie, v ktorých sa nachádza nastavenie rozsahu pohybu servomotora.
Pri funkcii actuatorWrite, bolo potrebné zmeni´ rozsah pohybu servomotora a tieº prevod hodnôt zadávaných do funkcie na hodnoty, ktoré budú vstupova´ do servomotora pri jeho riadení. Pri pôvodnej verzii i²lo a jednodu-

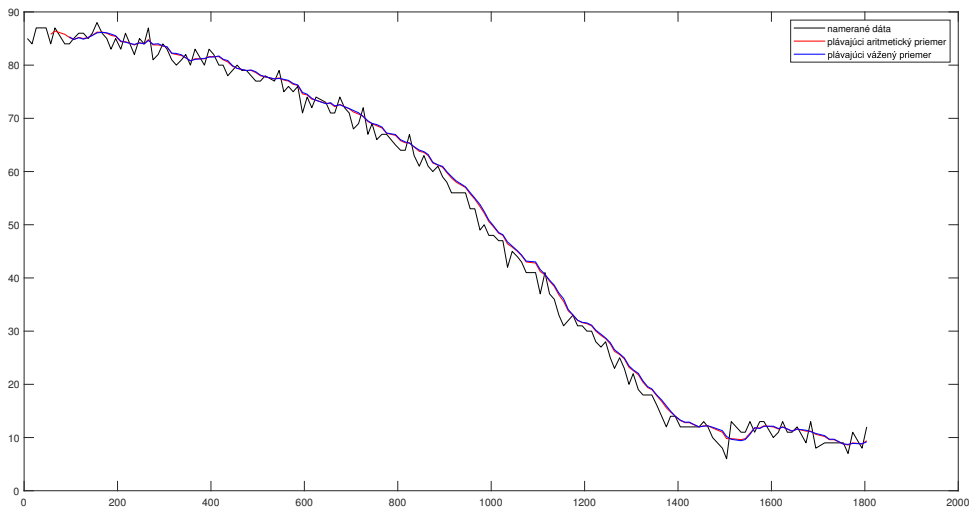
[picture p25: figure]
namerané dáta

plávajúci aritmetický priemer Obr. 3.4: Porovnanie plávajúceho artimetického a váºeneého priemeru

chý prevod za pouºitia funkcie map , kedy sa vstupné hodnoty z rozsahu -30 aº 30 menili na hodnoty 65 aº 125, pri£om i²lo a prevod celých £ísel na celé £ísla.
Ke¤ºe na²ím cie©om bolo zlep²i´ presnos´ otá£ania trubi£ky a teda zvý²i´ po£et hodnôt, ktoré môºe nadobúda´, rozhodli sme sa pre implementáciu prevodu, v ktorom 1◦na servomotore sa rovná 0,2◦na trubi£ke. Z tohto dôvodu nie je moºné vyuºi´ funkciu map, ke¤ºe uº ide o prevod desatinných £ísiel na celé. Pre prevod sme sa rozhodli pouºi´ funkciu mapFloat naprogramovanú v kniºnici AutomationShield, ktorá prevádza hodnoty desatinných £ísiel opä´ na desatinné £ísla. Teda z premennej degree, ktorá slúºi na posielanie hodnôt na servomotor, sa nám stane desatinné £íslo. Servomotor v²ak dokáºe pracova´ len s celými £íslami a preto je potrebné pouºi´ funkciu round(), ktorá nám premennú degree zaokrúhli na celé £íslo, ktoré uº následne môºeme pouºi´ pri riadení servomotora. Za hodnoty vstupu sme si zvolili rozsah -17 aº 17 a za výstupný rozsah uhlov na servomotore 10 aº 170.
Funkcia calibration funguje na princípe h©adania krajných hodnôt vzdialeností guli£ky v trubi£ke pri jej pohybe. Najprv h©adá minimálnu hodnotu. Nastaví trubi£ku do krajnej hodnoty rozsahu jej otá£ania a zmeria 100 hodnôt, z ktorých následne urobí aritmetický priemer a ten vloºi do premennej min-Calibrated. To isté sa deje aj pri h©adaní maximálnej hodnoty, ktorú vloºí do premennej maxCalibrated. Jediné £ím sa funkcia lí²i vo verzii R3 od pôvodnej verzie sú krajné hodnoty oto£enia trubi£ky, tie bolo teda potrebné upravi´ pre ná² hardvér.

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

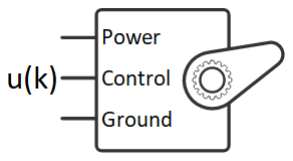
[picture p26: figure]

Obr. 3.5: blok Actuator Write

r(k)

Obr. 3.6: blok Reference Read

hodnoty v percentách, kde hodnoty, ktoré získavame, budú z intervalu od 0 po 100 v závislosti od polohy beºca potenciometra. al²ou moºnos´ou je získavanie hodnôt v podobe napätia v rozsahu od 0 po 5 V. Poslednou dostupnou moºnos´ou nastavenia £ítania hodnôt z potenciometra je analógová hodnota z intervalu od 0 po 1023. V závislosti od potreby uºívate©a blok poskytuje teda ur£itú exibilitu v závislosti od aplikácie v ktorej ho chceme vyuºi´.
al²ím blokom je Sensor Read a slúºi nám na získavanie aktuálnej polohy guli£ky v trubi£ke. Ide o blok slúºiaci na komunikáciu mikropo£íta£a s na²ím ToF sníma£om VL6180X prostredníctvom I2C protokolu. Pouºívate© si môºe vybra´ z typov výstupných hodnôt zo sníma£a. Prvou moºnos´ou je vzdialenos´ v mm, ktorá nám dáva vzdialenos´ guli£ky od sníma£a v trubi£ke. al²ou z moºnosti je pozícia guli£ky v mm. Ide o úpravu vzdialenosti, kde sa za po£iato£nú pozíciu povaºuje koncový bod trubi£ky v ktorom sa nenachádza ToF sníma£, teda výstupné hodnoty sú inverzné vo£i vzdialenosti. Pri vo©be výstupu v percentách sú potrebné kalibra£né hodnoty aby vedel blok u£i´ minimálnu a maximálnu meranú hodnotu pre daný typ telesa v trubi£ke. Tie je moºné zada´ niº²ie v okne parametrov bloku kedy si môºeme zvoli´ bu¤ defaultne nastavené hodnoty 0 aº 100 mm alebo nastavi´ nami namerané krajné hodnoty pomocou manuálneho zadávania.

Obr. 3.7: blok Sensor Read

Posledným blokom je blok Filtrated Sensor Read (obr. ), ktorého úlohou je vyh©adenie ²umu sníma£a pri meraní vzdialenosti guli£ky. Ide o implementácia ltrácie signálu, ktorú sme si zvolili na základe testovaní viacerých typov ltrácií na nami nameranej zloºke dát. Na vyhladenie ²umu pouºívame plávajúci aritmetický priemer po£ítaní z posledných piatich nameraných hodnôt. Daný blok sme vytvorili ako subsystém, do ktorého sme vloºili blok Sensor Read a výstup z neho sme vloºili do bloku Moving Averge, v ktorom sme si za ve©kos´ okna (parameter window length) zvolili 5 hodnôt a jeho výstup sme zaviedli na výstup zo subsystému.

### 3.2.2 PID príklad

Riadenie systému pomocou PID regulátora je jeden z najznámej²ích typov riadenia systému. Na²e zariadenie sme sa teda rozhodli riadi´ pomocou PID regulátora v uzavretej riadiacej slu£ke (obr.3.8 ). V princípe sa v schéme nachádza slu£ka so spätnou väzbou zo zariadenia, ktorá porovnáva aktuálny stav systému s referen£nou hodnotu a na základe toho vyhodnocuje ak£ný zásah do systému. V na²om zapojení referen£nú hodnotu dostávame z bloku Reference Read, ktorý nám ponúka aktívne ju meni´ pomocou otá£ania beºcom na potenciometri. Spätnú väzbu o stave zariadenia sme získavame prostredníctvom bloku Filtered Sensor Read, ktorý nám hovorí o aktuálnej pozícii guli£ky v zariadení. Blok PID nám následne na základe vypo£ítanej chyby ur£í ak£ný zásah do systému a po²le ho do bloku Actuator Write, ktorý následne nastaví pozíciu servomotora do poºadovanej hodnoty.

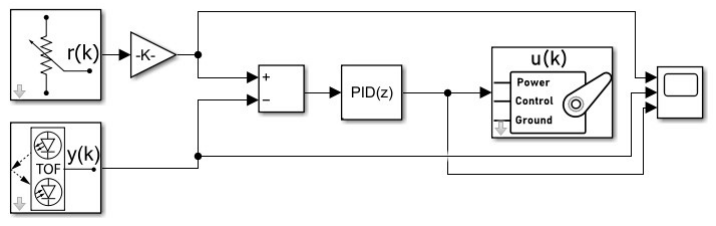
[picture p27: figure]

Obr. 3.8: Schéma zapojenia - príklad PID riadenia

Na obrázku 3.9 môºeme vidie´ výstup z priebehu riadenia, kedy krivka £iernej farby reprezentuje referen£nú hodnotu, modrá aktuálnu pozíciu guli£ky a £ervená ak£ný zásah do systému. Môºeme vidie´, ºe zariadenie na zmenu referen£nej hodnoty aktívne reaguje a snaºí sa pomocou zásahu do systému regulova´ polohu guli£ky v danej polohe. Guli£ka zatia© len osciluje okolo referen£nej polohy ale po dôkladnom naladení by mal by´ systém schopný udrºa´ jej pozíciu priamo na poºadovanej hladine. Momentálne z h©adiska problémov pri komunikácii hardvéru s rozhraním Simulink sme neboli schopný aplikova´ riadny a detailný proces ladenia PID regulátora. No môºeme vidie´, ºe daný

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

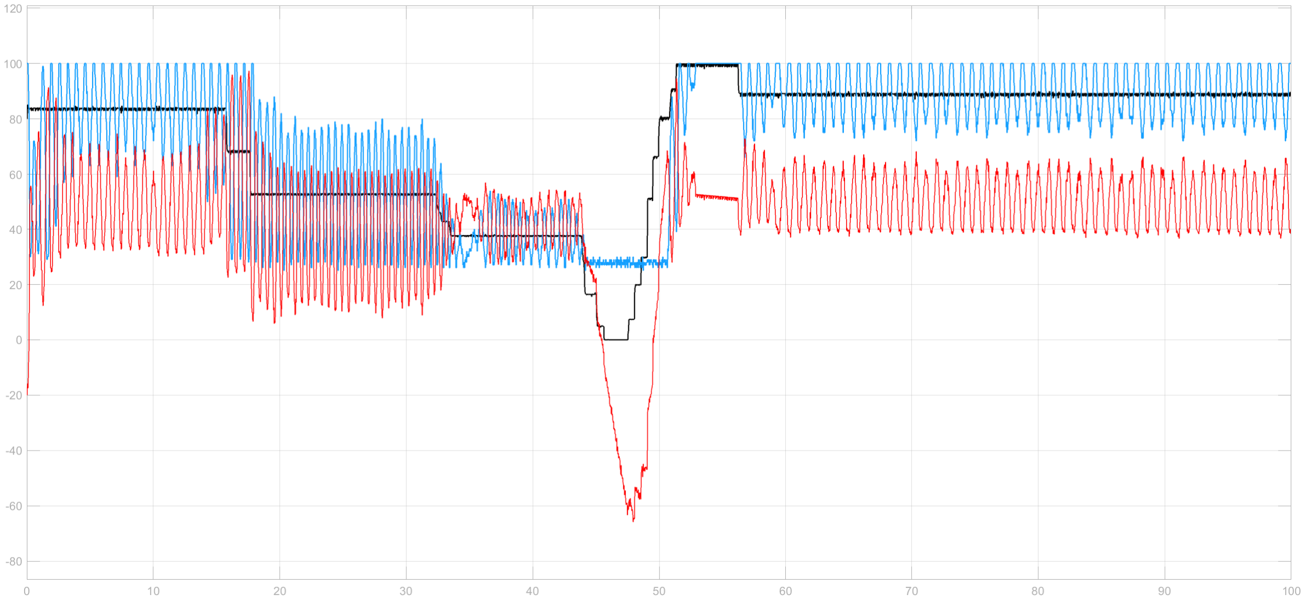
[picture p28: figure]

## 4 Záver

Cie©om tejto bakalárskej práce bolo zrevidova´ existujúci hardvér, navrhnú´ a realizova´ jeho zmeny, vytvori´ API v programovacom prostredí Simulink a zrealizova´ príklady riadenia systému na novom hardvéry a v novom programovacom prostredí.
Podarilo sa nám výrazne vylep²i´ hardvérovú £as´ zariadenie, kde sme pomocou aplikácie prevodu medzi servomotorom a trubi£kou zvý²ili presnos´ jej otá£ania z 1◦na 0,2◦
. Tieº sme dôkladnou analýzou výberu vhodnej guli£ky pre ná² systém zníºili smerodajnú odchýlku pri meraní sníma£a. Z h©adiska softvéru sme pridali do pôvodnej kniºnice v Arduino IDE, funkcie na ltráciu ²umu a upravili sme pôvodné funkcie aby boli kompatibilné s obidvoma verziami zariadenia R2 a R3. Vytvorili sme API pre Simulink a overili jeho funk£nos´ na príklade PID riadenia systému.
Taktieº sme sa snaºili o tvorbu API v programovacom prostredí MATLAB, ku ktorému sme vytvorili kniºnicu, no narazili sme na problém v komunikácii medzi programovacím prostredím MATLAB a ToF sníma£om, ktorý sme v na²om zariadení pouºili. Tento problém mohol vzniknú´
Do budúcna zariadenie stále ponúka priestor na zlep²enie. Môºe dôjs´ ku tvorbe nových príkladov LQ riadenia pre obe API, taktieº ku procesu identi-kácie systému na novom hardvéry. Taktieº ku tvorbe funkcie na nastavenie vodorovnej polohy trubi£ky pri kalibrácii systému, ktorá nemohla by´ vytvorená z dôvodu nedodanie komponentov na jej realizáciu.

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

## Literatúra

[1] STMicroelectronics, VL6180X - Proximity and ambient light sensing module [online], 2016, [cit 2022-4-21] Dostupné z: https://www.st.com/resource/en/datasheet/vl6180x.pdf
[2] InvenSense Inc., MPU-6000 and MPU-6050 Product Specication Revision 3.4 [online], 2013 [cit. 2022-4-21] Dostupné z: https://invensense.tdk.com/wp-content/uploads/2015/02/MPU-6000-Datasheet1.pdf
[3] STMicroelectronics, ST732 Datasheet [online], 2021 [cit. 2022-
4-28] | Dostupné | z: | https://www.mouser.sk/ProductDetail/
STMicroelectronics/ST732M28R?qs=MLItCLRbWsxtXiiWQqtIMw%3D%3D
[4] A. Vargová, BoBShield: a miniature "ball on beamëxperiment, Slovenská technická univerzita v Bratislave, Strojnícka fakulta, 2021, Bratislava, Slovenská republika
[5] CTMS - Control tutorials for MATLAB and SIMULINK, Ball and Beam: System Modeling [online], [cit. 2022-5-12] Dostupné z: https: //github.com/gergelytakacs/AutomationShield/wiki/BoBShield
[6] G. Takacs, BOBShield [online], [cit. 2022-4-22] Dostupné z: https: //www.hennlich.sk/fileadmin/user_upload/sk_gufer%C3%A1_-_preh%C4%BEad_profilov.pdf
[7] ISL Products International Ltd., Servo Motor Fundamentals [online]. [cit. 2022-5-20] Dostupné z: https://islproducts.com/design-note/servo-motor-fundamentals/
[8] DFROBOT, 9g Metal Gear Micro Servo (1,8Kg) [online]. [cit. 2022-4-22] Dostupné z: https://www.dfrobot.com/product-1338.html
[9] SAVOX-SERVO, Savox - Servo - SH-0253 - Digital - DC - Motor [online]. [cit. 2022-5-22] Dostupné z: https://www.savox-servo.com/Servos-c-1338/Brushed-Motor-c-1340/Savox-Servo-SH-0253-Digital-DC-Motor/
[10] MOUSER Electronics, MPU-6050 [online]. [cit. 2022-5-12] Dostupné z: https://www.mouser.sk/ProductDetail/TDK-InvenSense/MPU-6050?qs=u4fy%2FsgLU9O14B5JgyQFvg%3D%3D

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
