MichalBiro/Bachelor-thesis/Latex/obr/PID-eps-converted-to.pdf

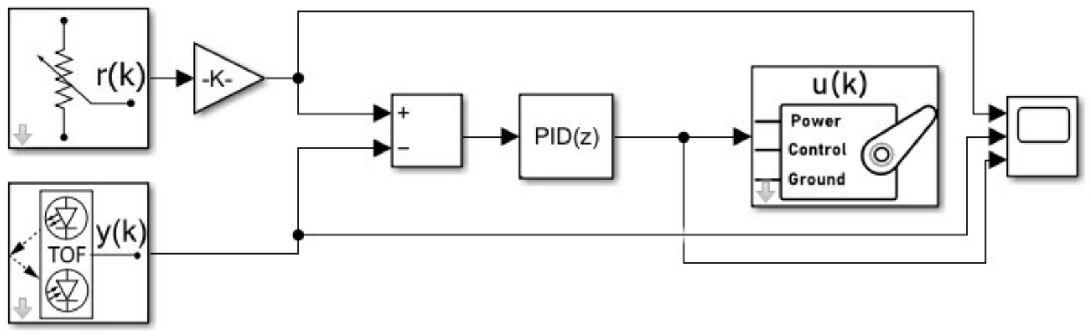
[picture p29: page 1]
