MichalBiro/Bachelor-thesis/Latex/obr/PIDgraf-eps-converted-to.pdf

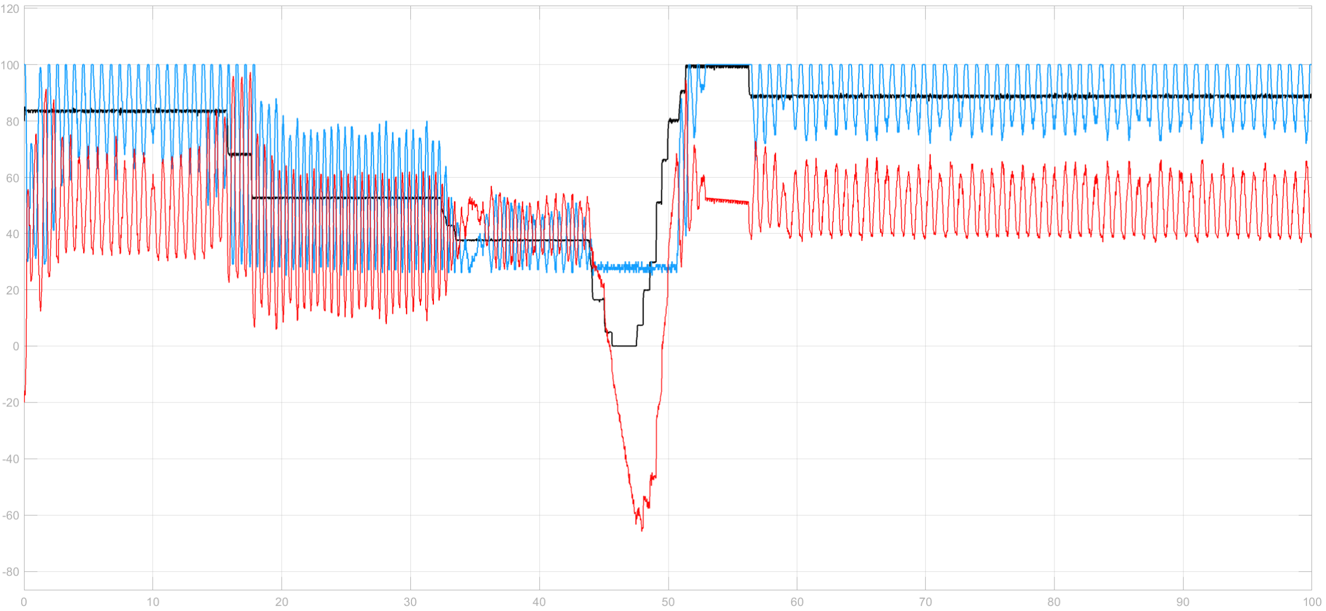
[picture p30: page 1]
