MichalBiro/Bachelor-thesis/Latex/obr/R1-eps-converted-to.pdf

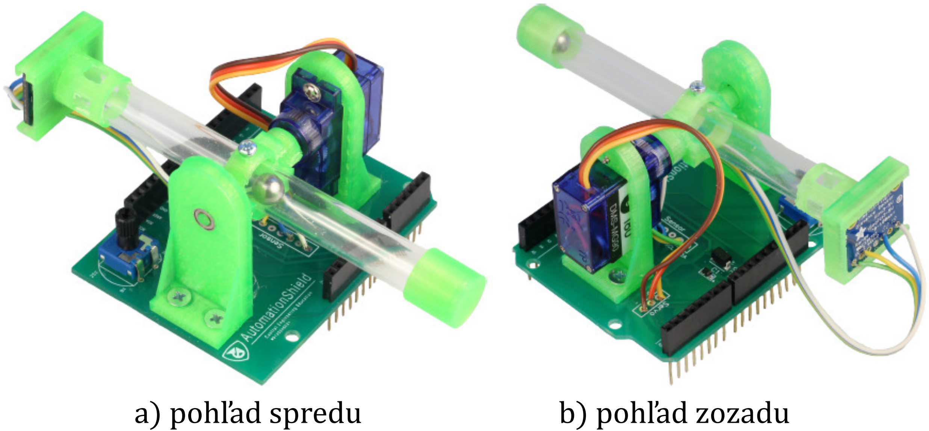
[picture p31: page 1]

a) poh ad spredu | b) poh ad zozadu
