MichalBiro/Bachelor-thesis/Latex/obr/3Dbase-eps-converted-to.pdf

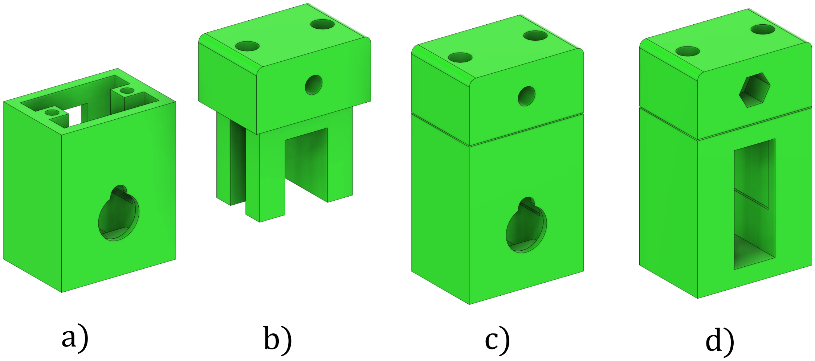
[picture p32: page 1]

a) | b) | c) | d)
