MichalBiro/Bachelor-thesis/Latex/obr/3Ddrziak-eps-converted-to.pdf

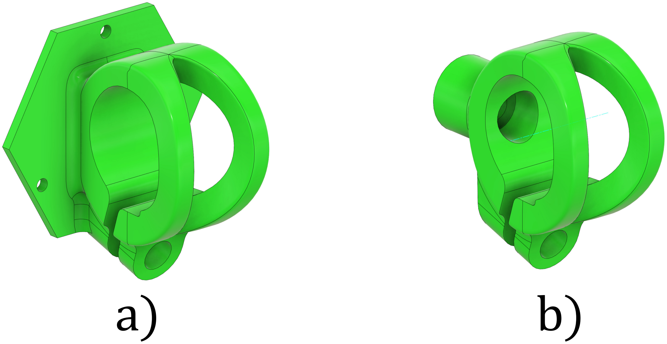
[picture p33: page 1]

a) b)
