MichalBiro/Bachelor-thesis/Latex/obr/3Dkolieska-eps-converted-to.pdf

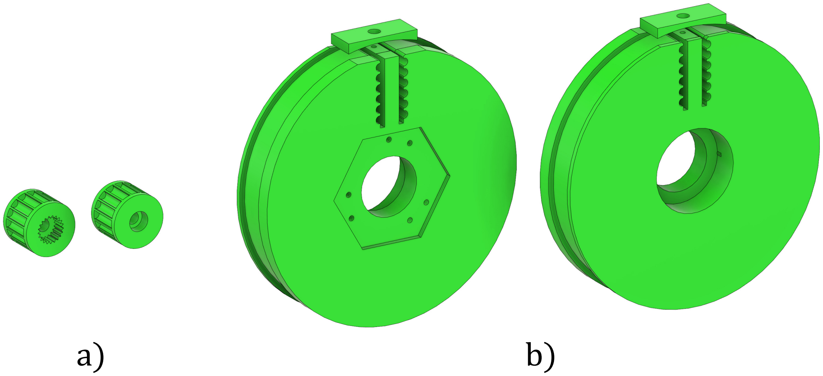
[picture p34: page 1]

a) b)
