MichalBiro/Bachelor-thesis/Latex/obr/BoBshield-eps-converted-to.pdf

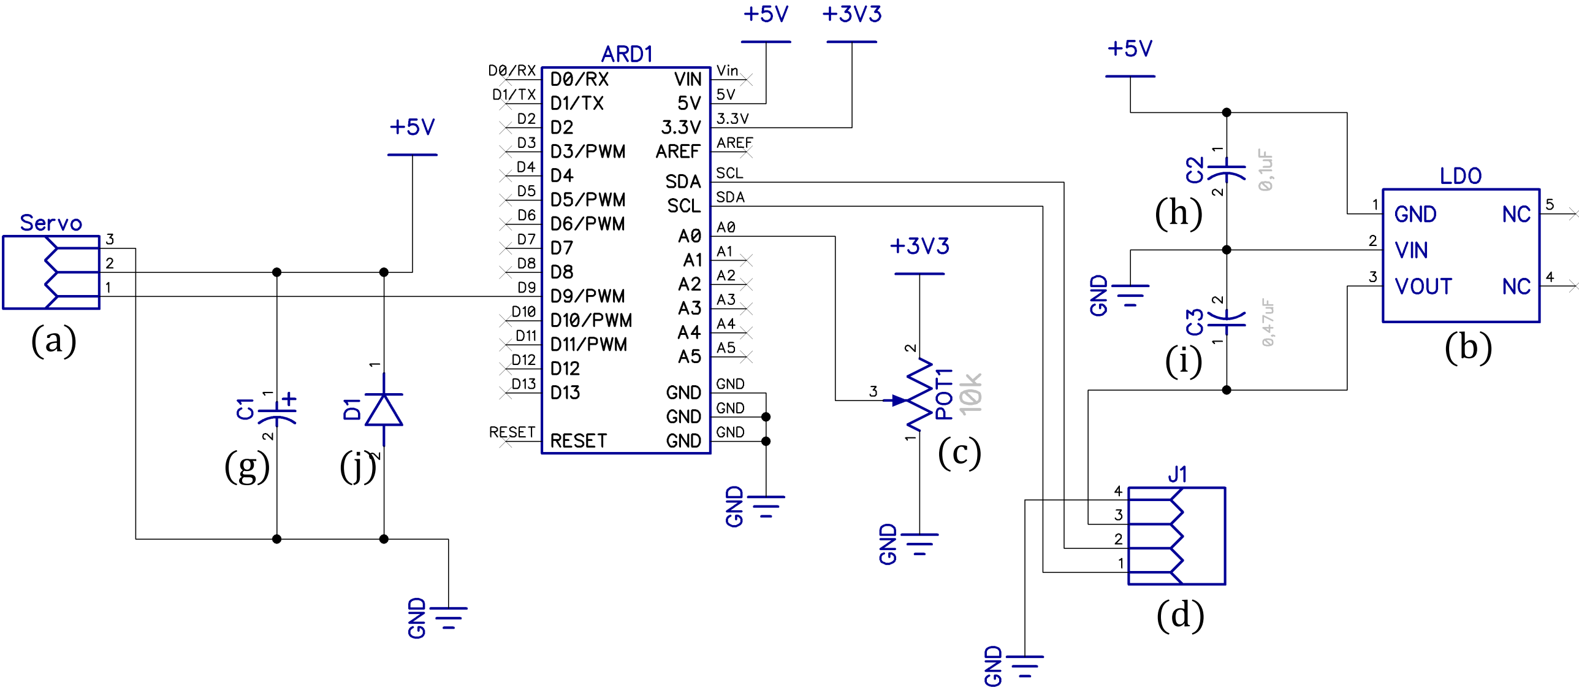
[picture p35: page 1]

(a) (b)

(c)

(d)

(g)

(h)

(i)

(j)
