MichalBiro/Bachelor-thesis/Latex/obr/LDOscheme-eps-converted-to.pdf

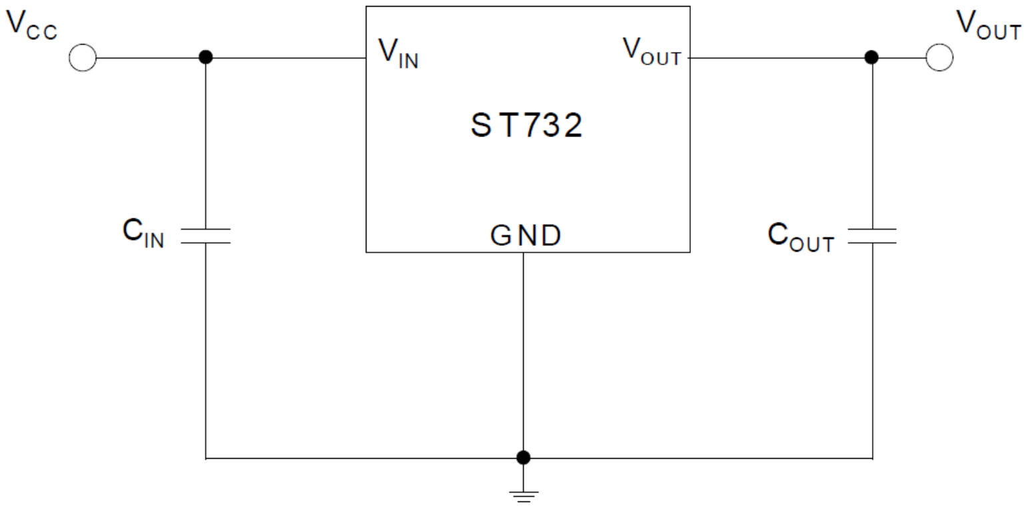
[picture p36: page 1]
