MichalBiro/Bachelor-thesis/Latex/obr/MPU6050-eps-converted-to.pdf

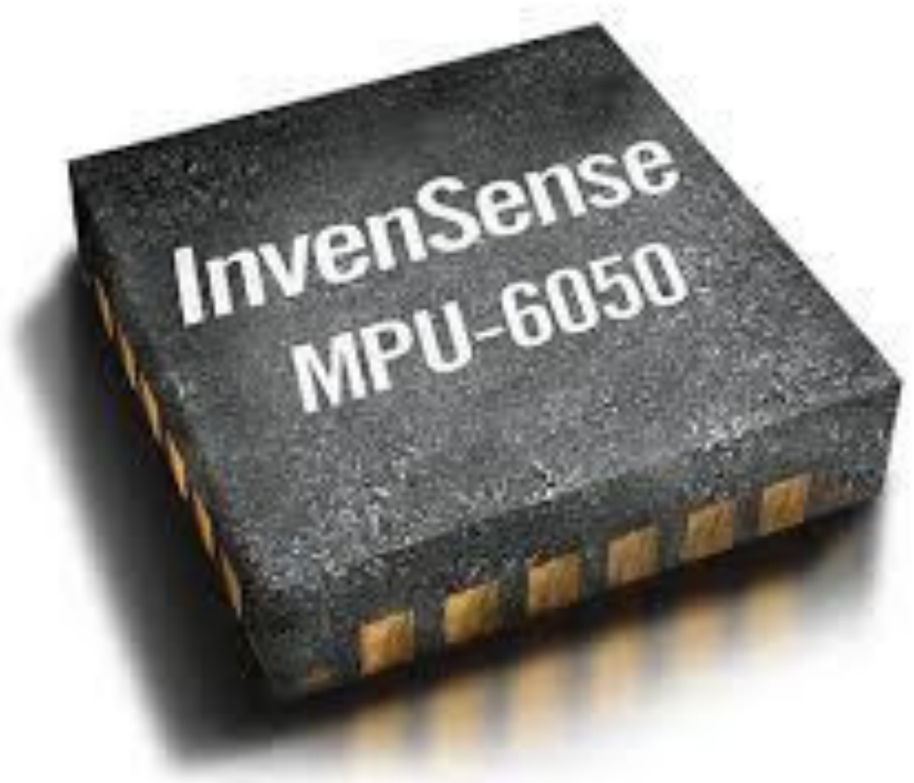
[picture p37: page 1]
