MichalBiro/Bachelor-thesis/Latex/obr/PCBBOBbottom-eps-converted-to.pdf

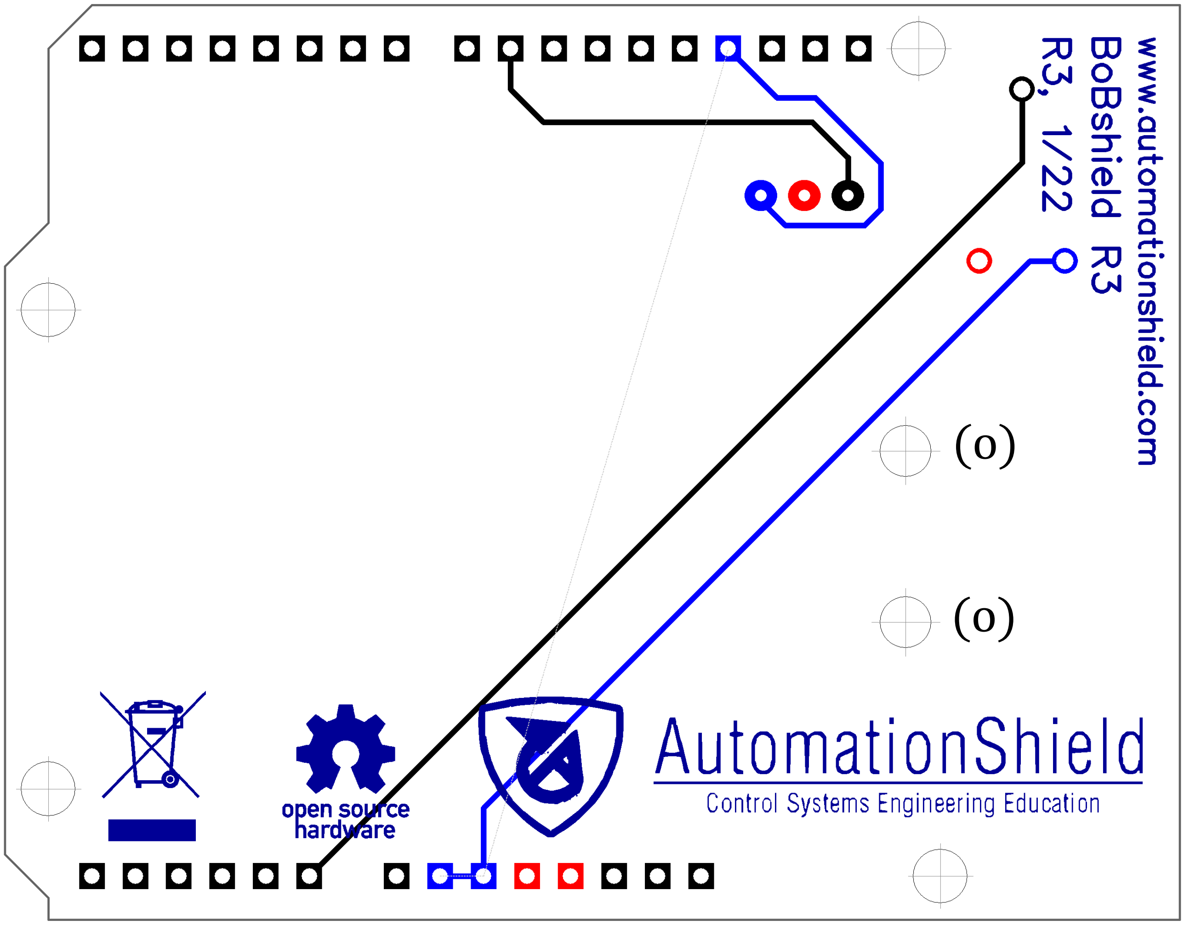
[picture p38: page 1]

(o)

(o)
