MichalBiro/Bachelor-thesis/Latex/obr/PCBBOBup-eps-converted-to.pdf

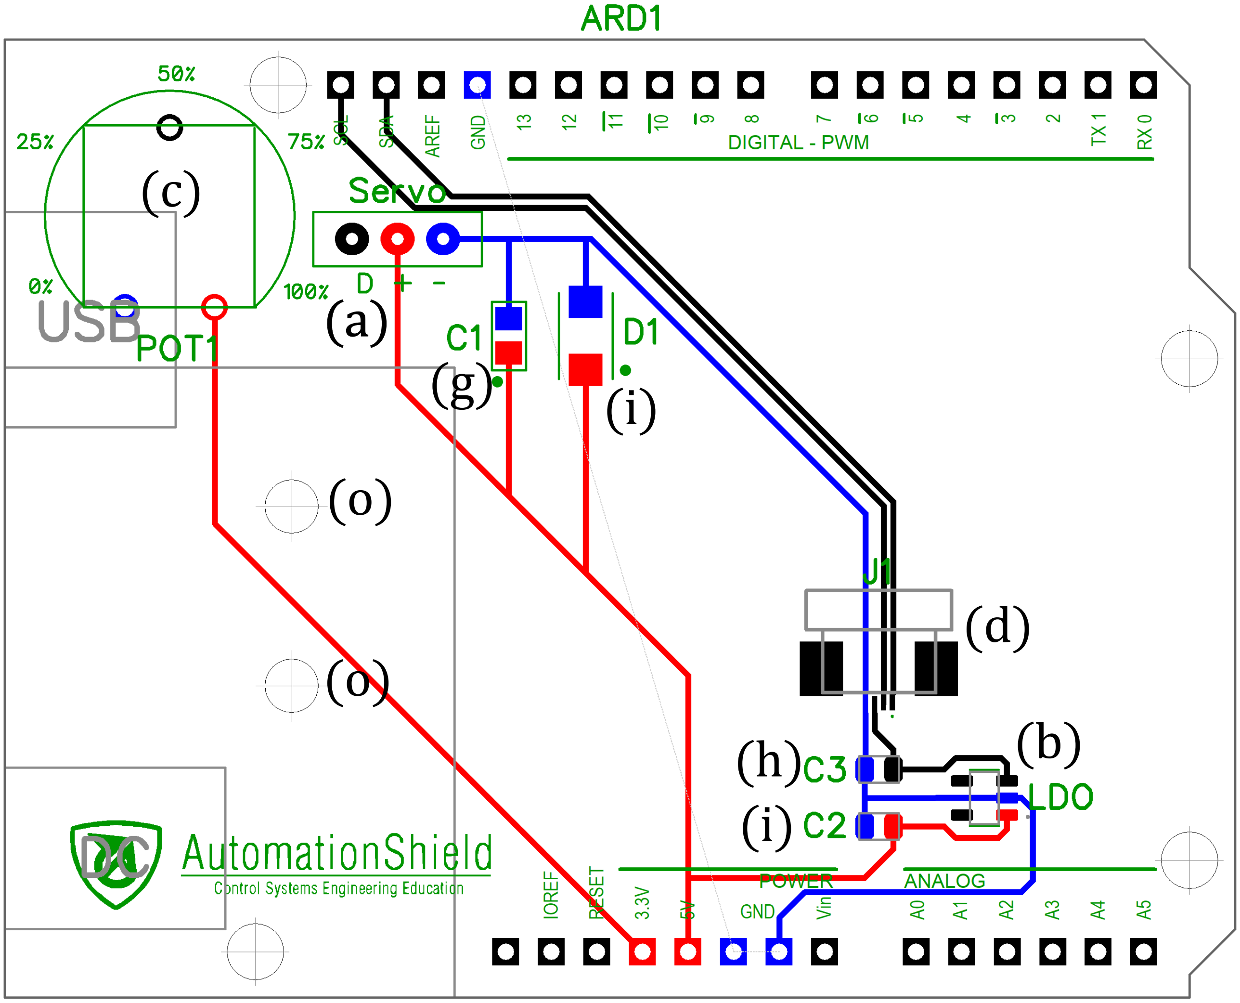
[picture p39: page 1]

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
