MichalBiro/Bachelor-thesis/Latex/obr/PCBsnimace-eps-converted-to.pdf

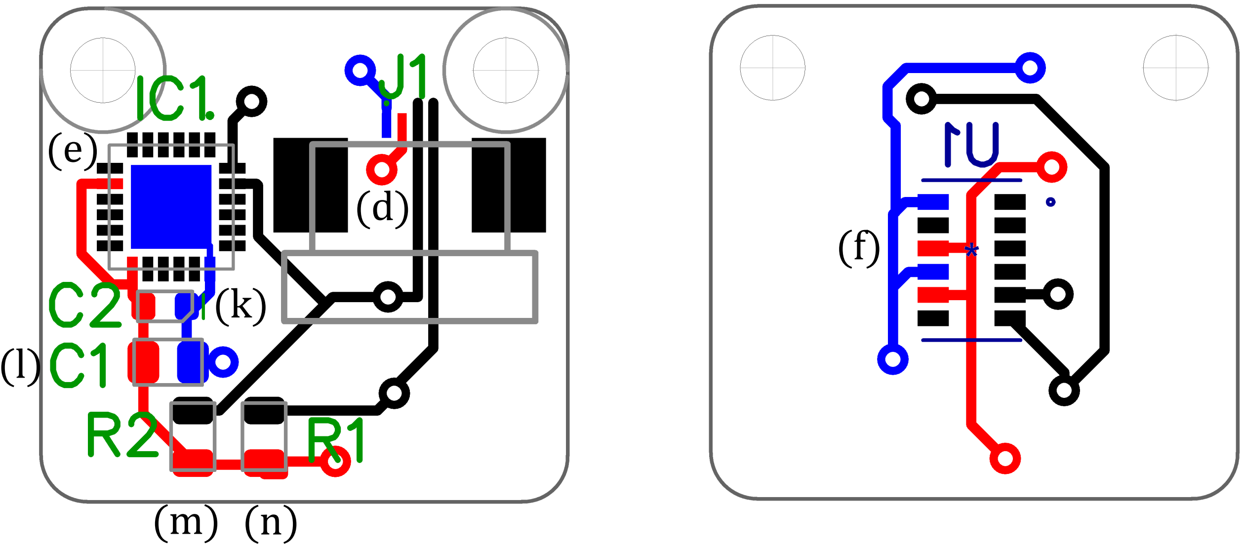
[picture p40: page 1]

(e)

(f)
(k)
(l)
(m) (n)

(d)
