MichalBiro/Bachelor-thesis/Latex/obr/Potentiometer-eps-converted-to.pdf

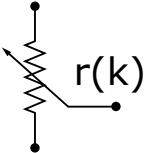
[picture p41: figure]
