MichalBiro/Bachelor-thesis/Latex/obr/prevod-eps-converted-to.pdf

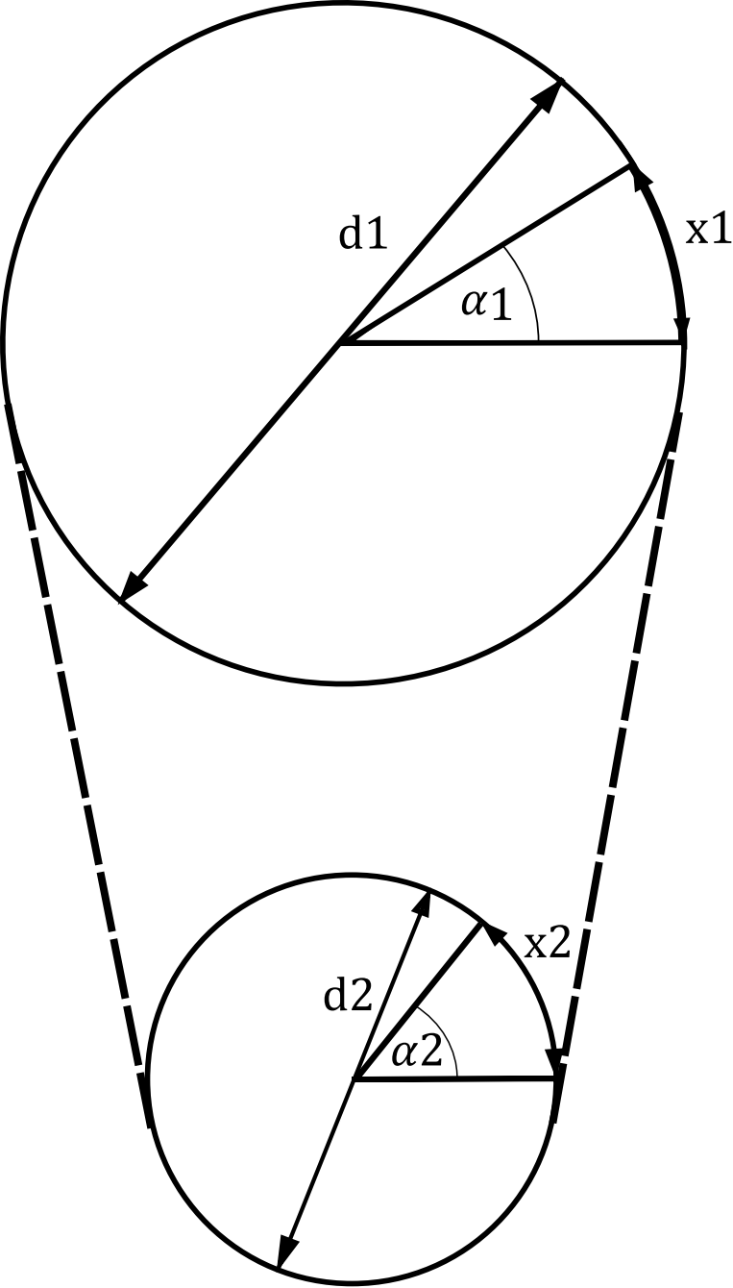
[picture p42: figure]
