MichalBiro/Bachelor-thesis/Latex/obr/PWMsignal-eps-converted-to.pdf

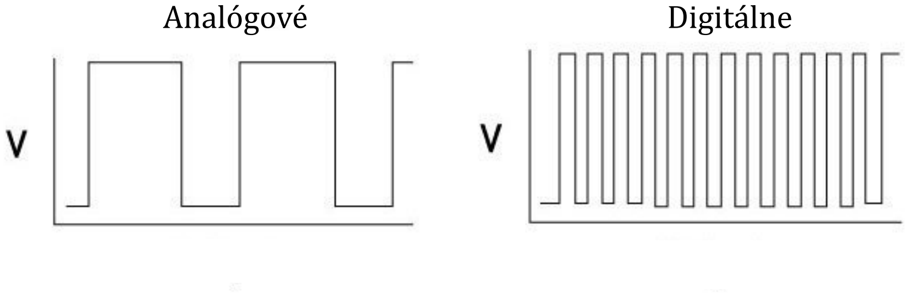
[picture p43: page 1]

Analógové | Digitálne
