MichalBiro/Bachelor-thesis/Latex/obr/senzors-eps-converted-to.pdf

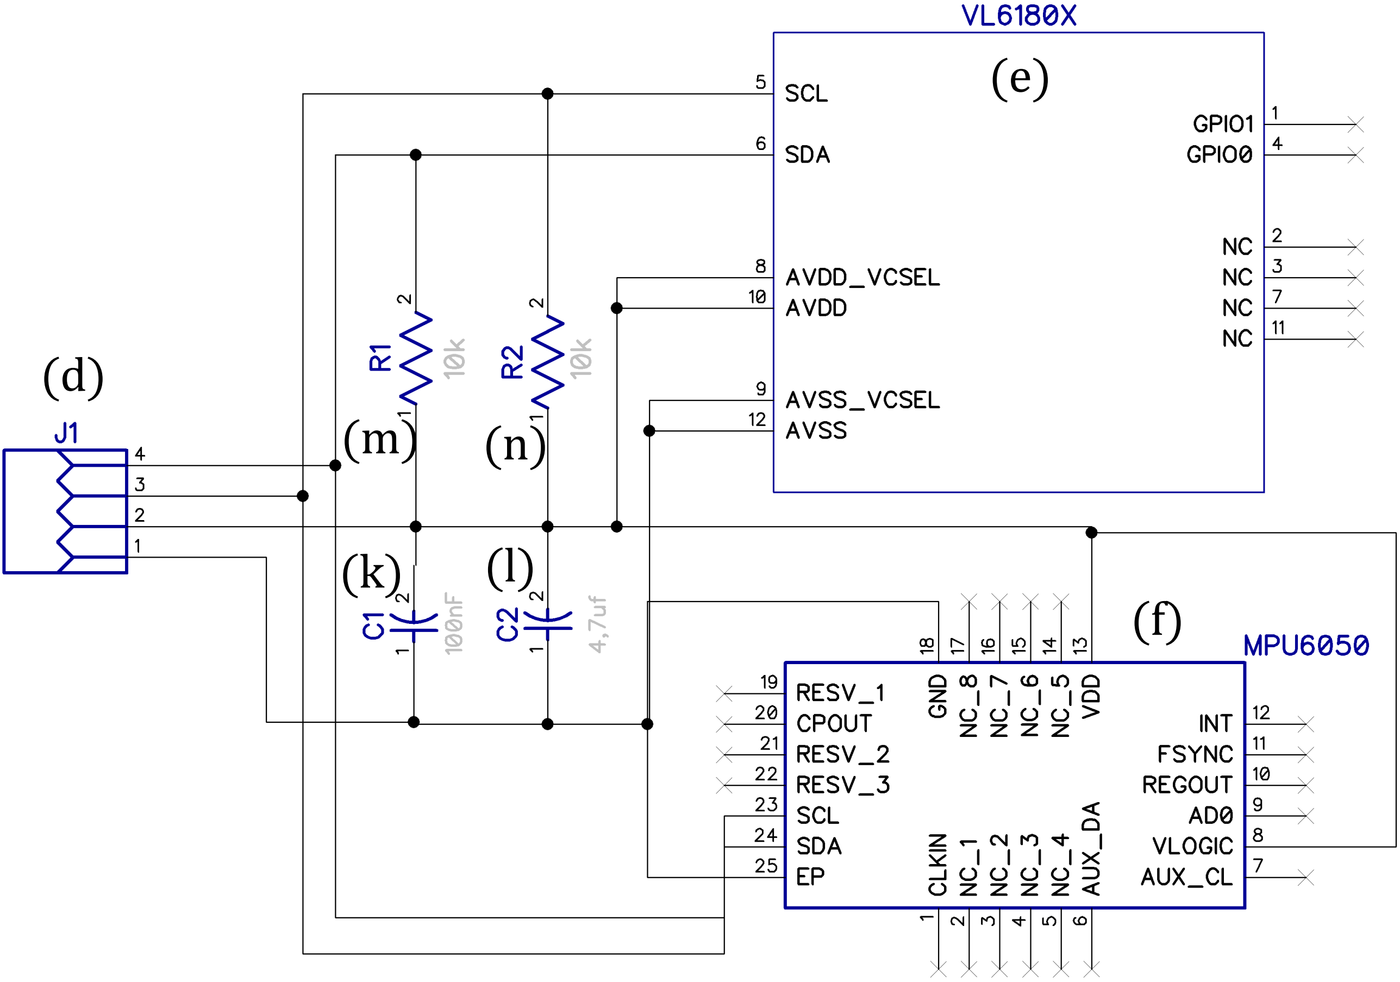
[picture p44: page 1]

(d)

(e)

(f)

(k) (l)
(m) (n)
