MichalBiro/Bachelor-thesis/Latex/obr/TOFreflectance-eps-converted-to.pdf

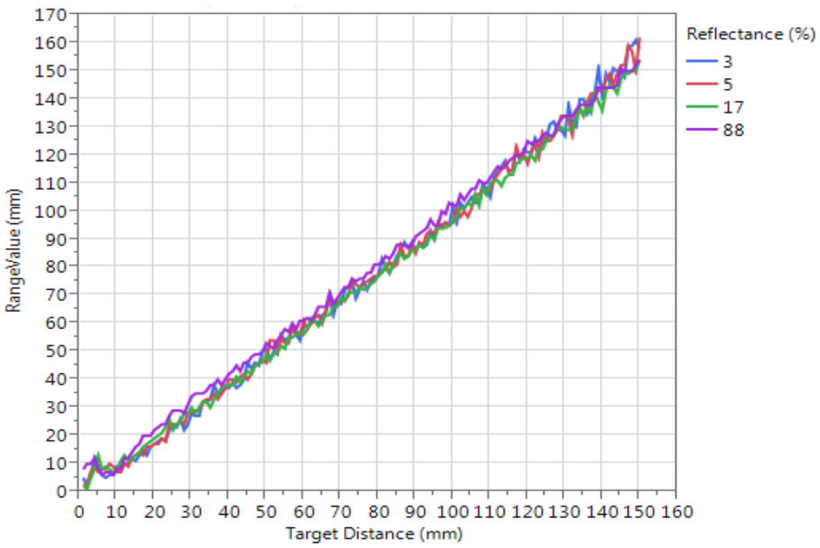
[picture p45: page 1]
