MichalBiro/Bachelor-thesis/Latex/obr/VL6180X-eps-converted-to.pdf

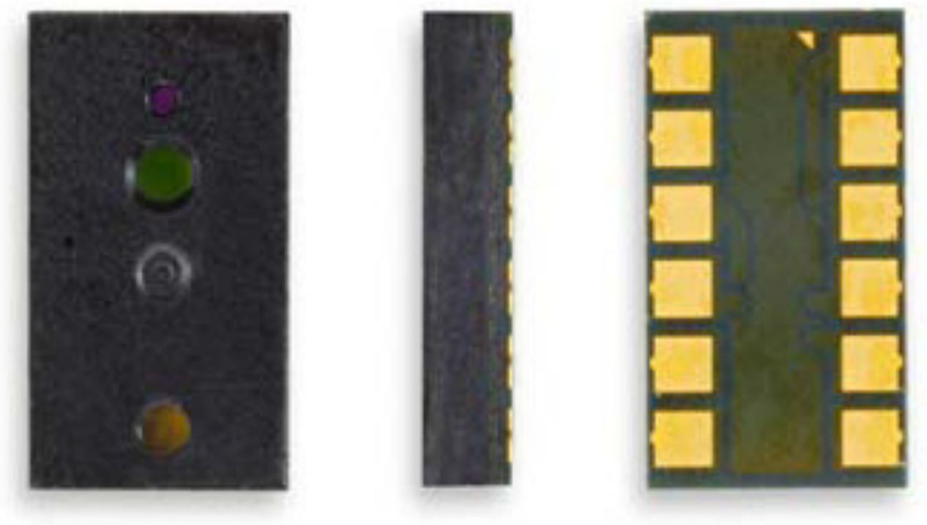
[picture p46: page 1]
