MichalBiro/Bachelor-thesis/Latex/obr/VL6180Xscheme-eps-converted-to.pdf

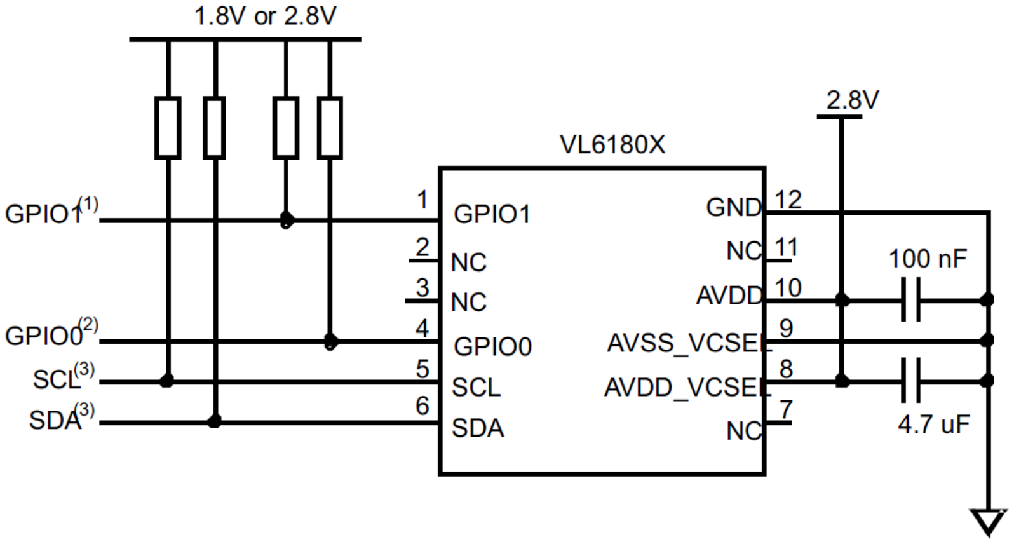
[picture p47: page 1]
