MichalBiro/Bachelor-thesis/Latex/obr/OBRAZOK1_1-eps-converted-to.pdf

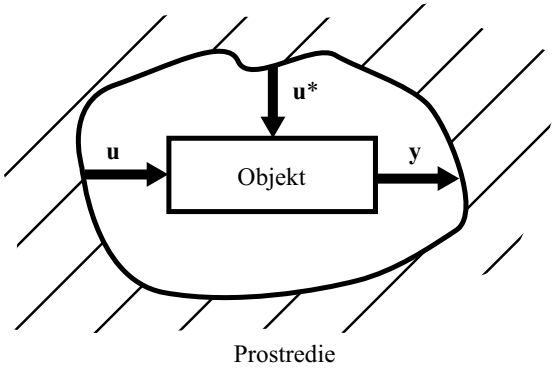
[picture p48: figure]
Objekt; Prostredie
