MichalBiro/Bachelor-thesis/Latex/obr/3Dbase.png

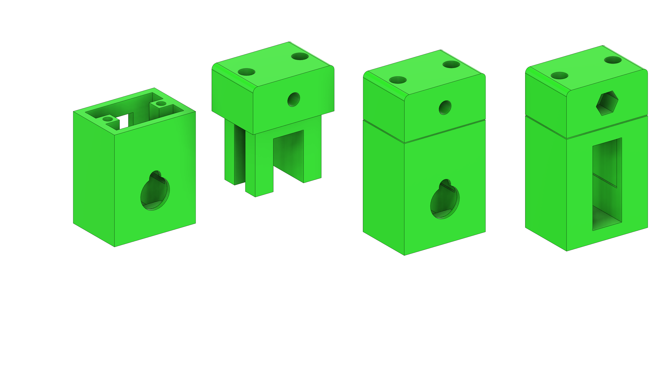
Latex/obr/3Dbase.png
