MichalBiro/Bachelor-thesis/Latex/obr/3Ddrziak.png

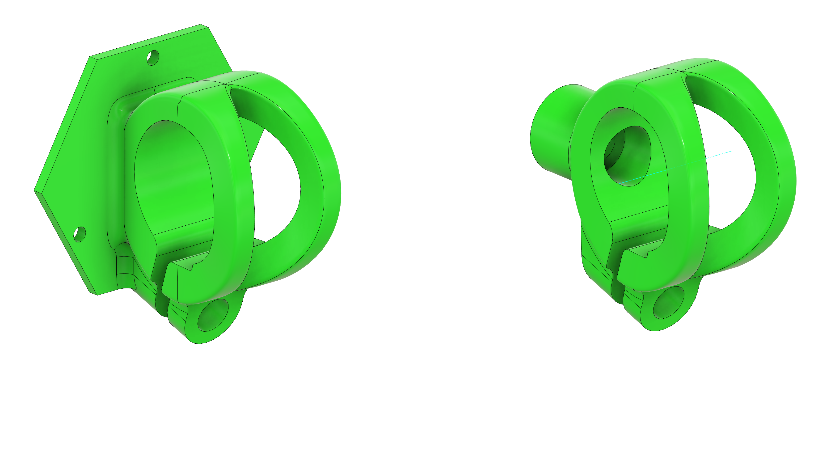
Latex/obr/3Ddrziak.png
