MichalBiro/Bachelor-thesis/Latex/obr/3Dkolieska.png

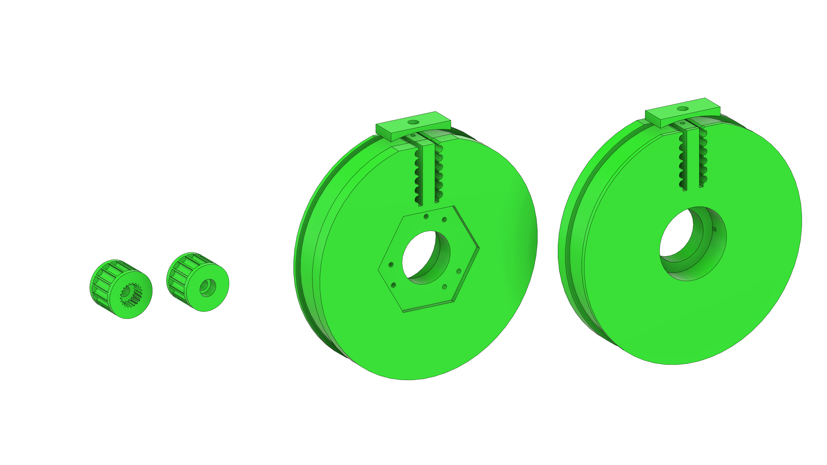
Latex/obr/3Dkolieska.png
