MichalBiro/Bachelor-thesis/Latex/obr/BoBshield.png

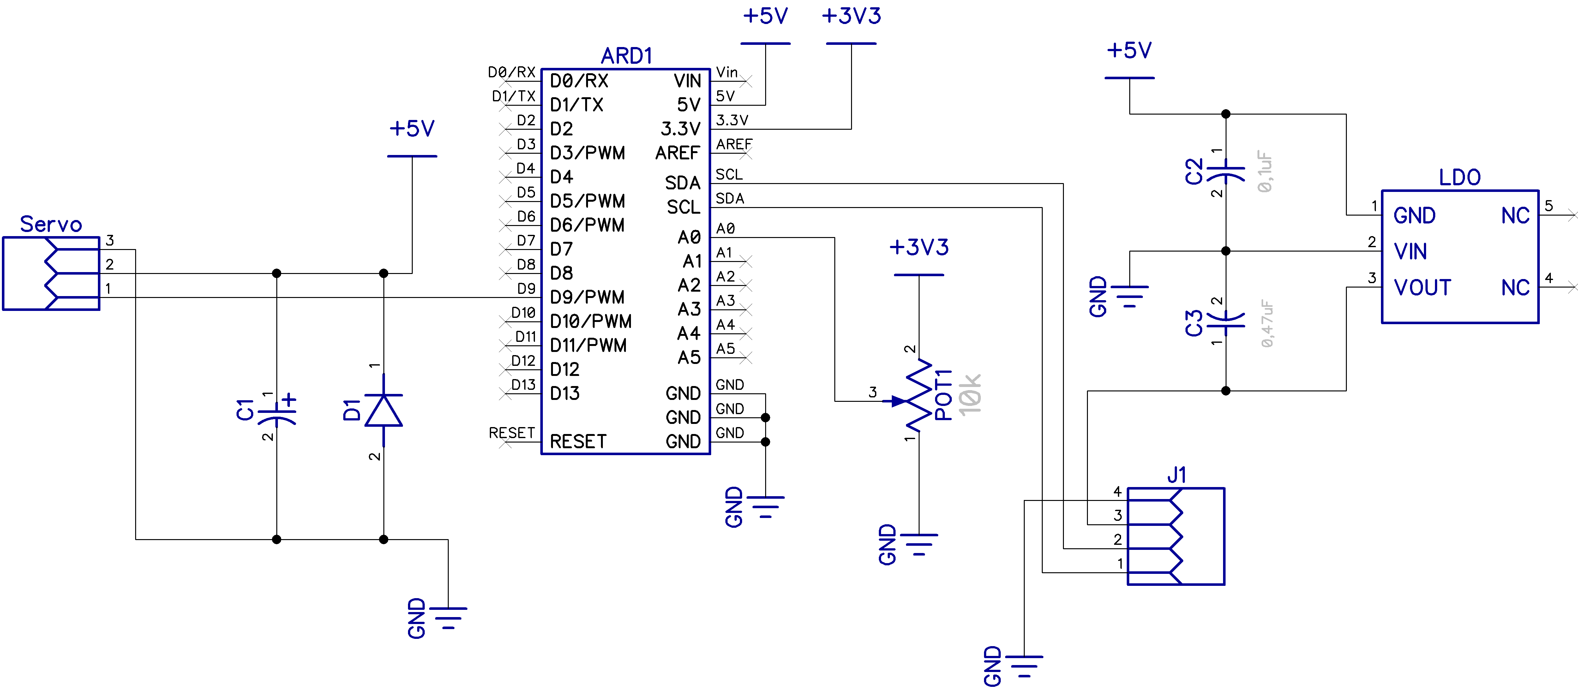
Latex/obr/BoBshield.png
