MichalBiro/Bachelor-thesis/Latex/obr/BoBshieldPCB.png

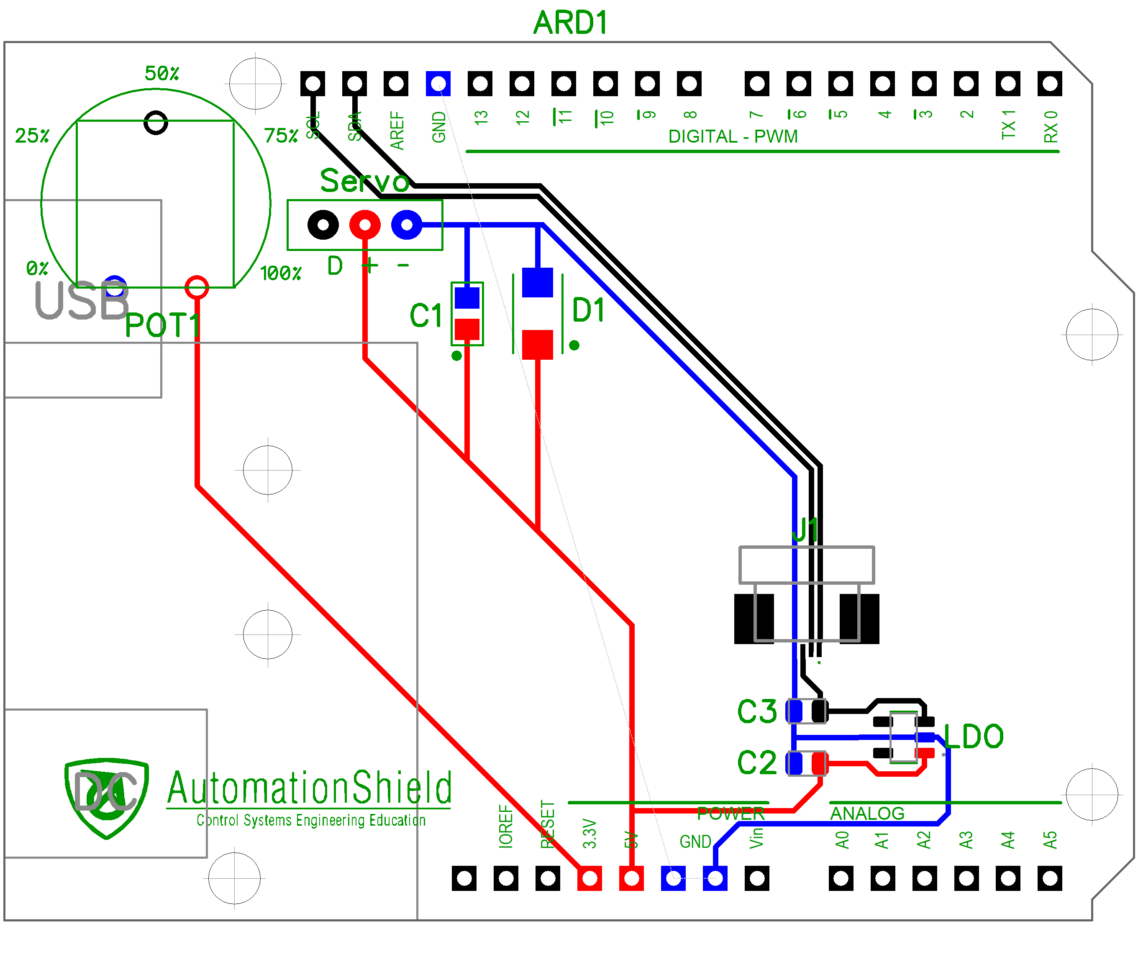
Latex/obr/BoBshieldPCB.png
