MichalBiro/Bachelor-thesis/Latex/obr/BoBshieldPCBbottom.png

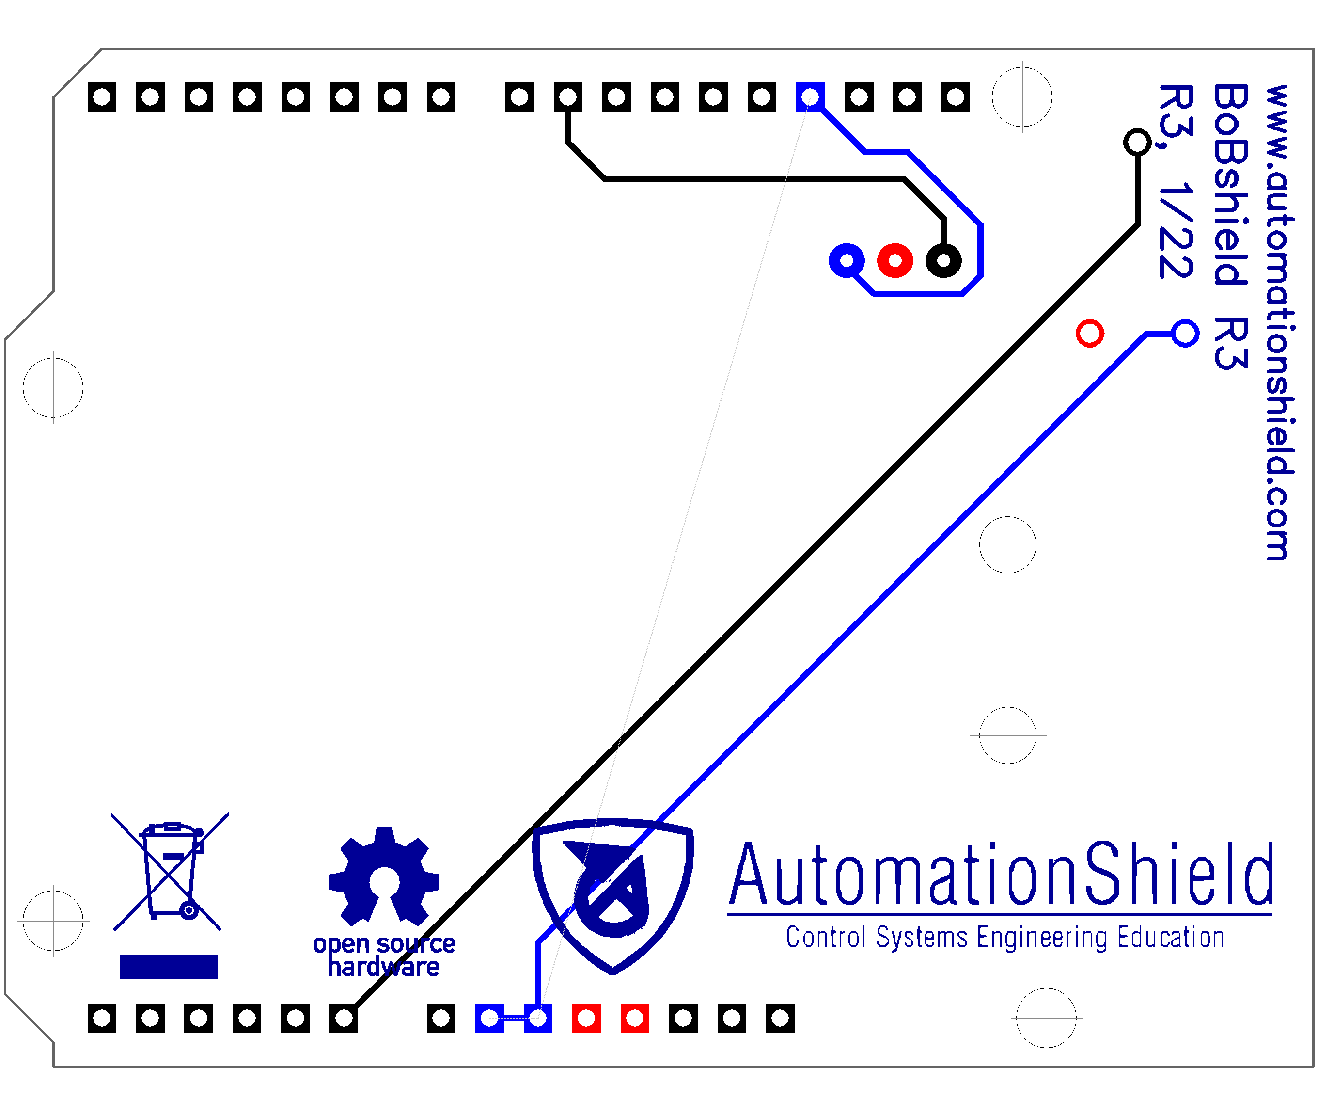
Latex/obr/BoBshieldPCBbottom.png
