MichalBiro/Bachelor-thesis/Latex/obr/R1.jpg

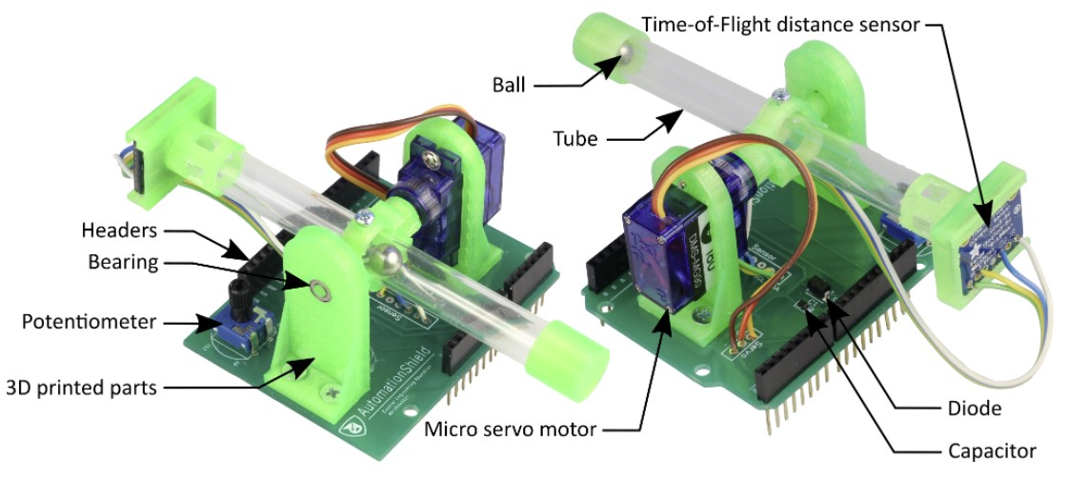
Latex/obr/R1.jpg
