MichalBiro/Bachelor-thesis/Latex/obr/senzors.png

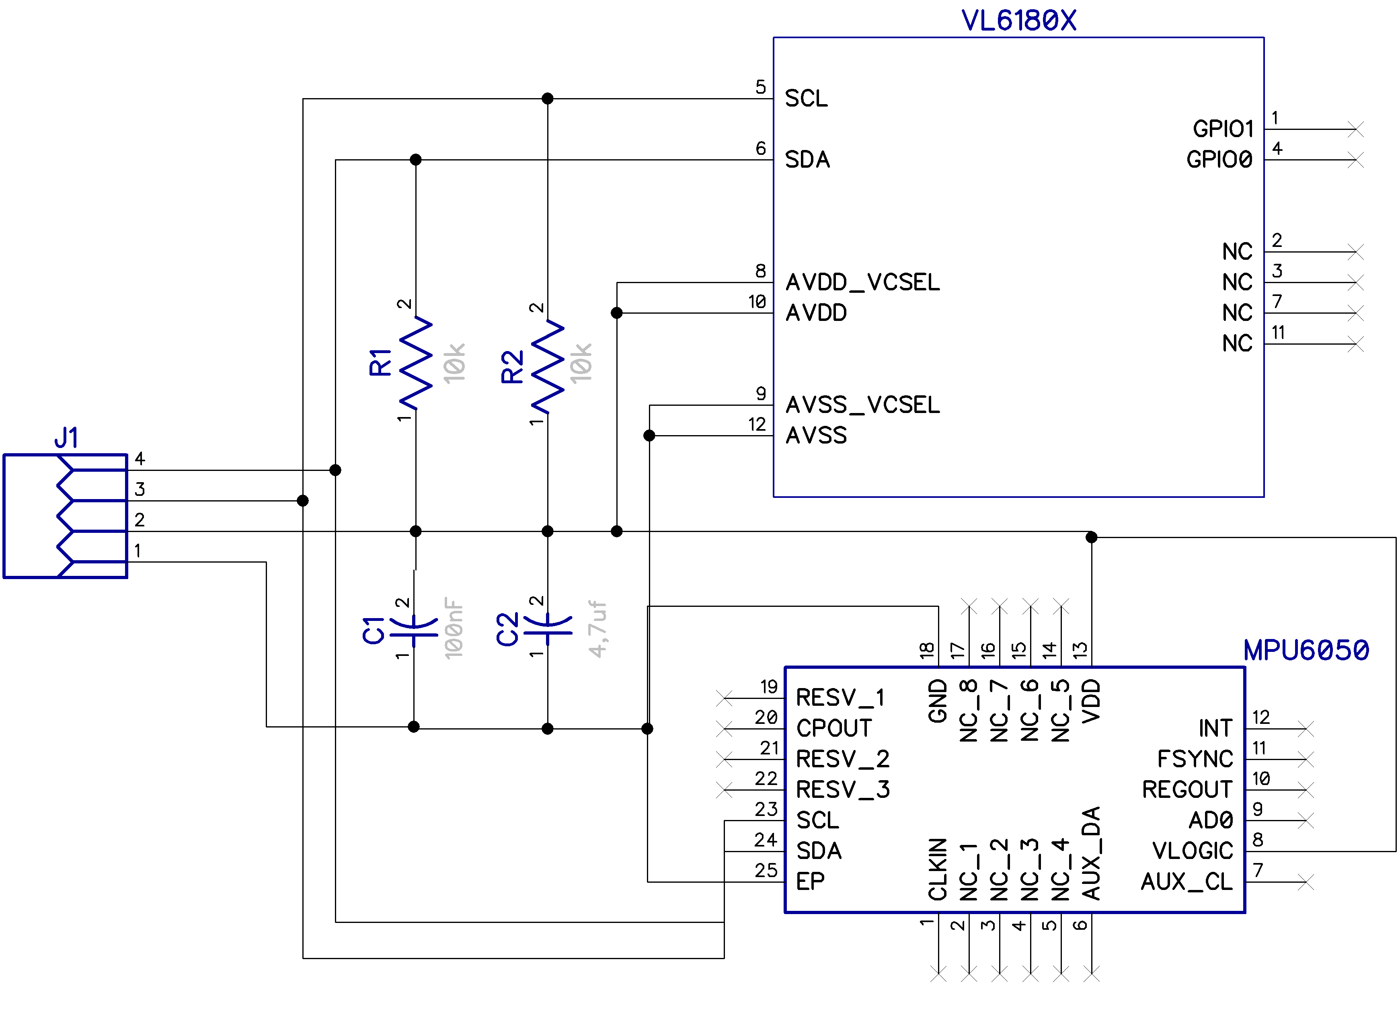
Latex/obr/senzors.png
