MichalBiro/Bachelor-thesis/Latex/obr/senzorsPCB.png

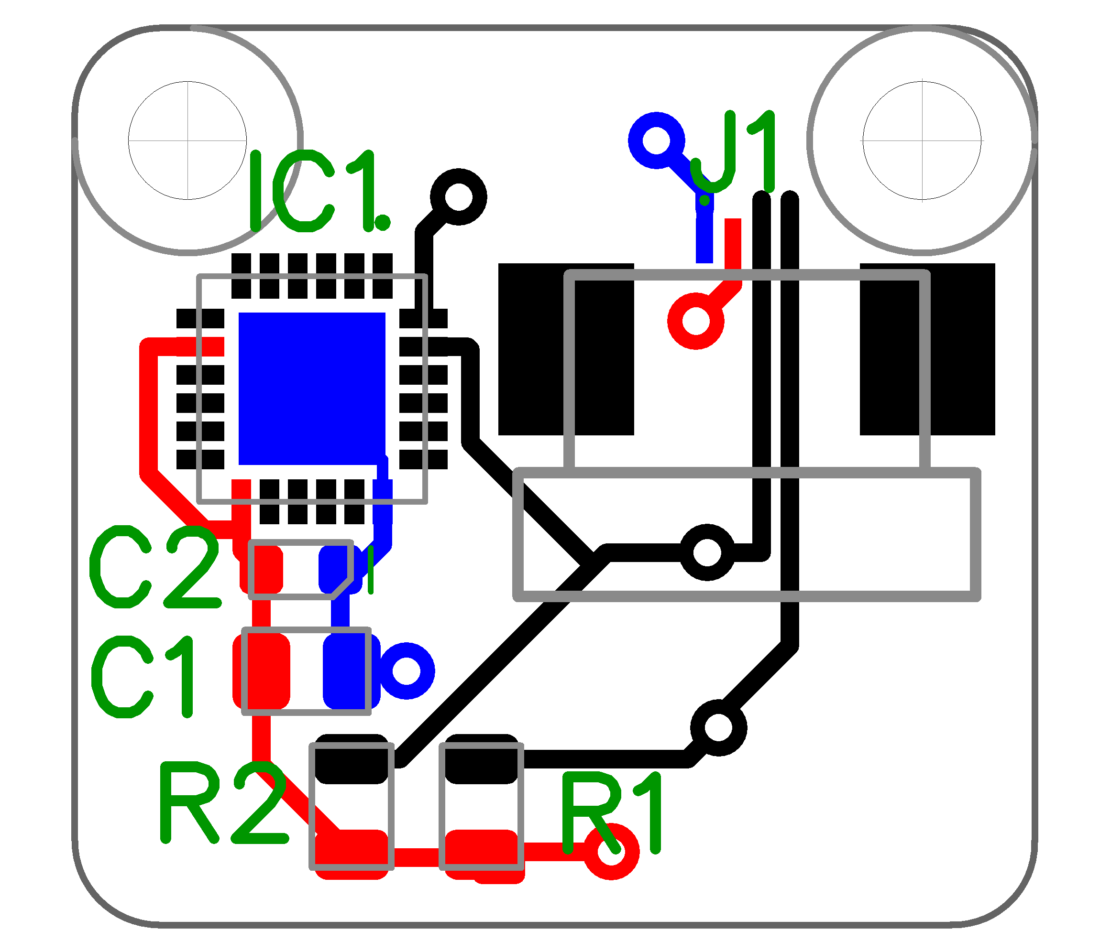
Latex/obr/senzorsPCB.png
