MichalBiro/Bachelor-thesis/Latex/obr/senzorsPCBbottom.png

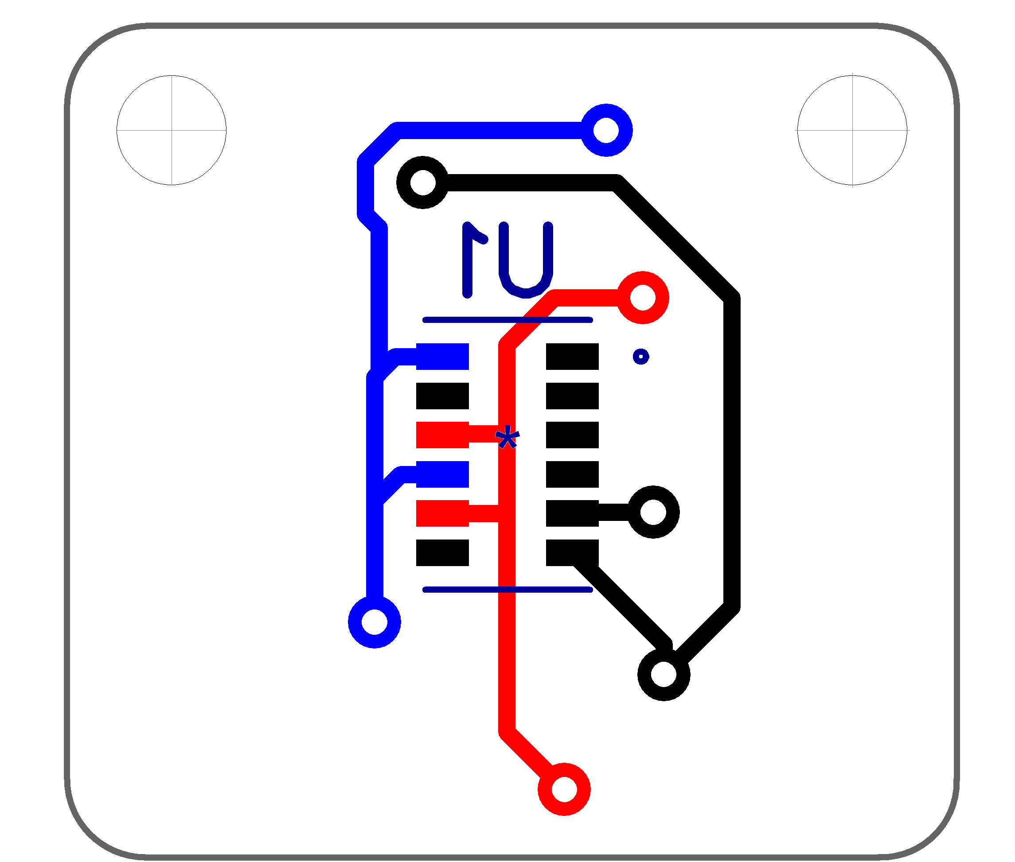
Latex/obr/senzorsPCBbottom.png
