MichalBiro/Bachelor-thesis/Latex/obr/tof.jpg

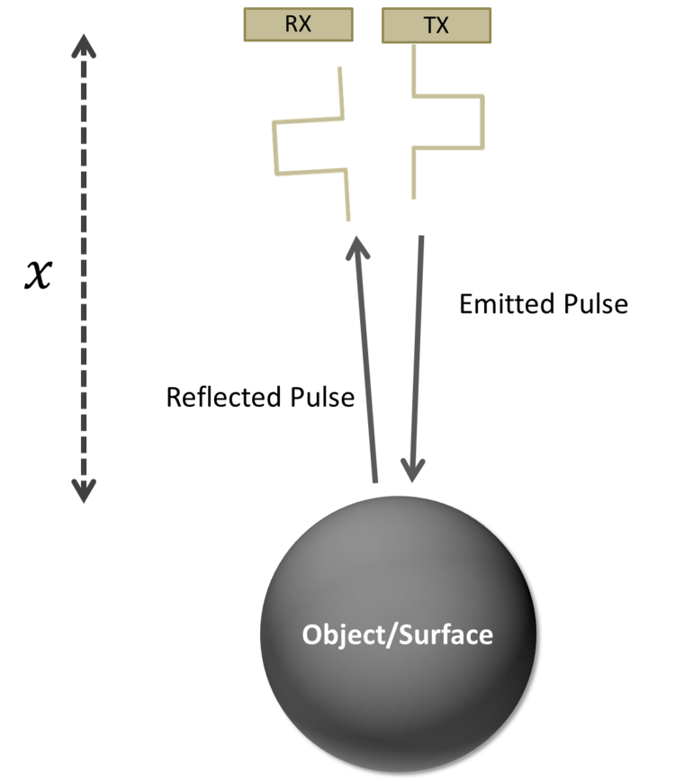
Latex/obr/tof.jpg
