MichalBiro/Bachelor-thesis/Latex/obr/experimentBOB-eps-converted-to.pdf

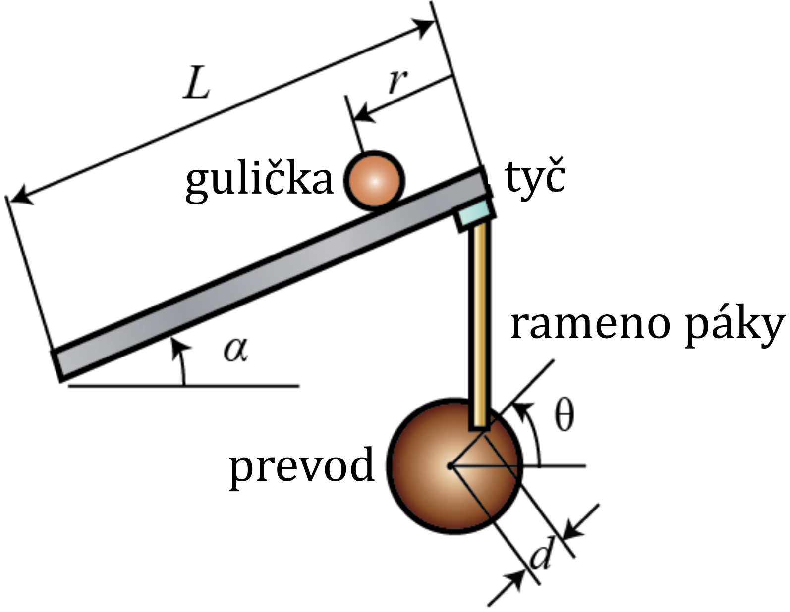
[picture p60: page 1]

guli ka | ty
| rameno páky

prevod
