MichalBiro/Bachelor-thesis/Latex/obr/aritmeticky-eps-converted-to.pdf

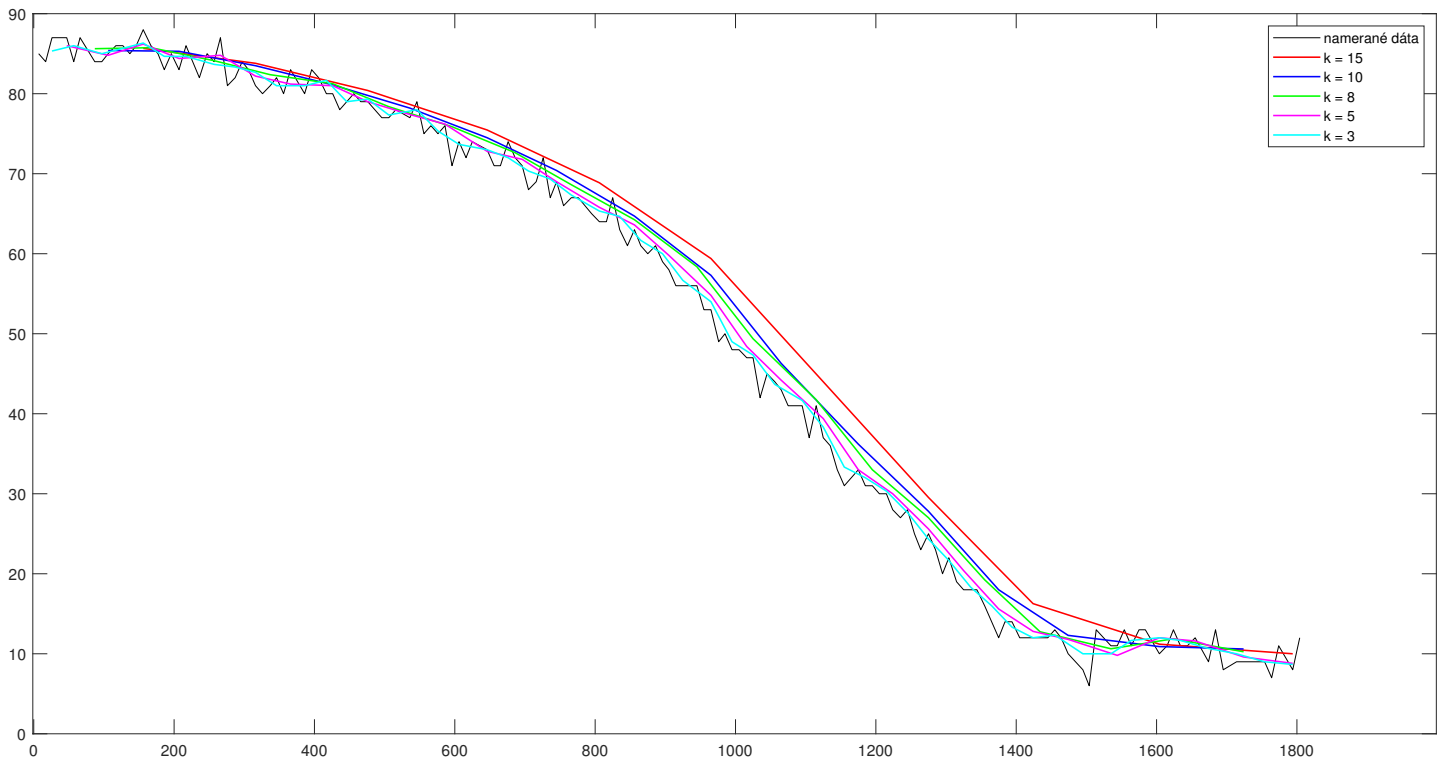
[picture p61: page 1]
namerané dáta
