MichalBiro/Bachelor-thesis/Latex/obr/aritmetickyVSvazeny-eps-converted-to.pdf

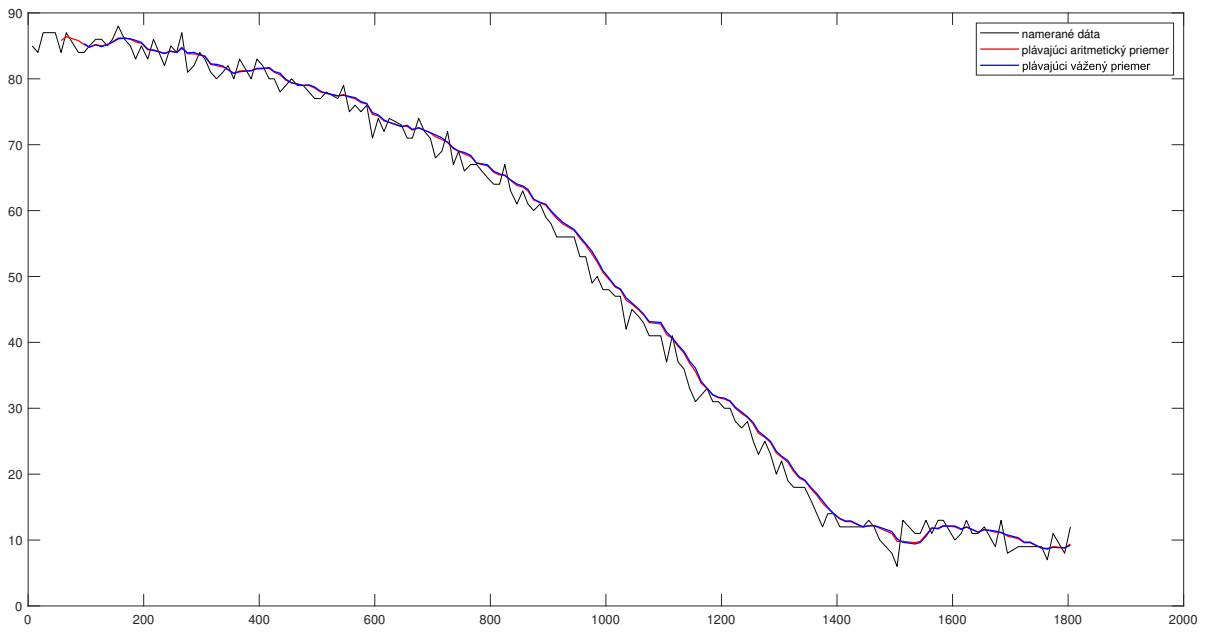
[picture p62: page 1]

namerané dáta
plávajúci aritmetický priemer
