MichalBiro/Bachelor-thesis/Latex/obr/plavajuciAritmeticky-eps-converted-to.pdf

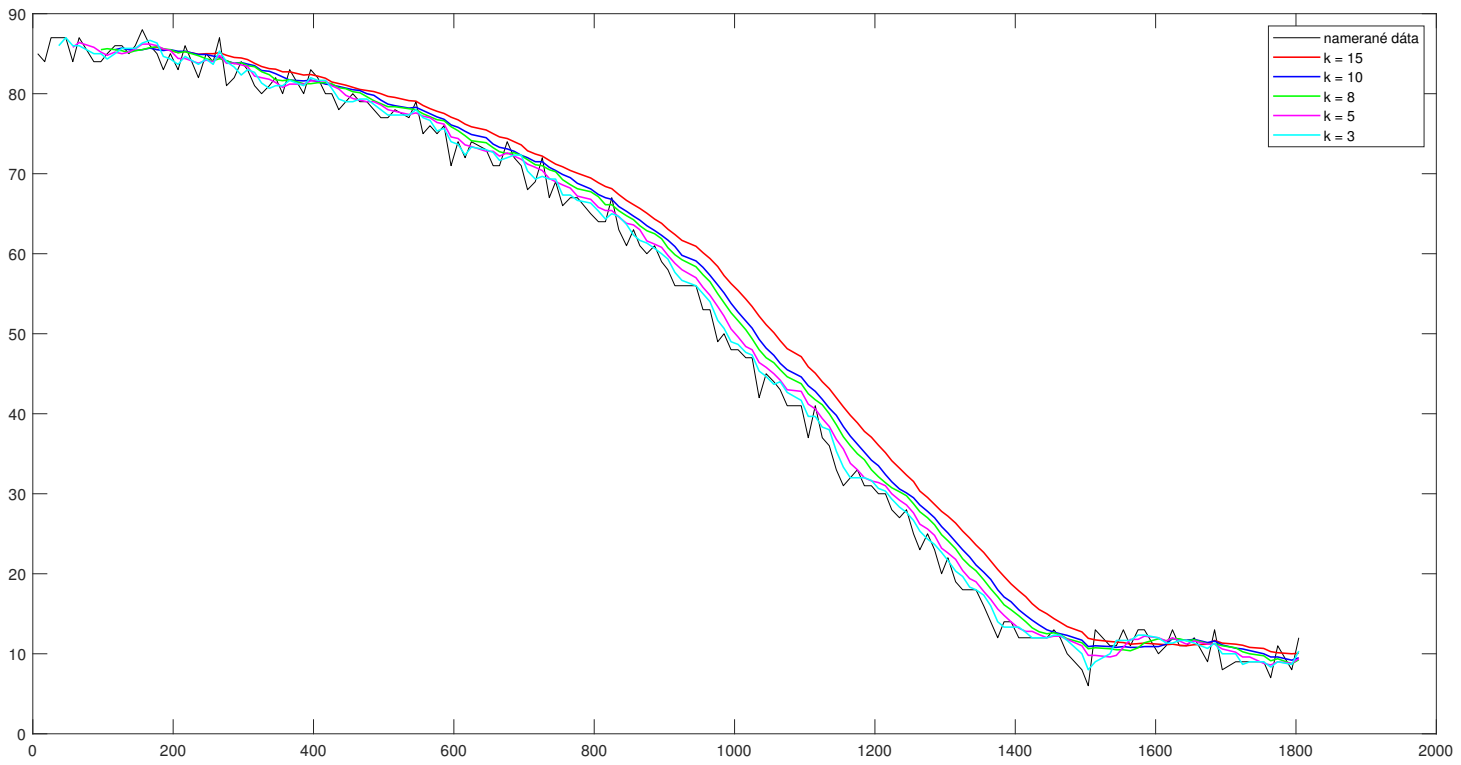
[picture p63: page 1]
namerané dáta
