MichalBiro/Bachelor-thesis/Latex/obr/plavajuciVazeny-eps-converted-to.pdf

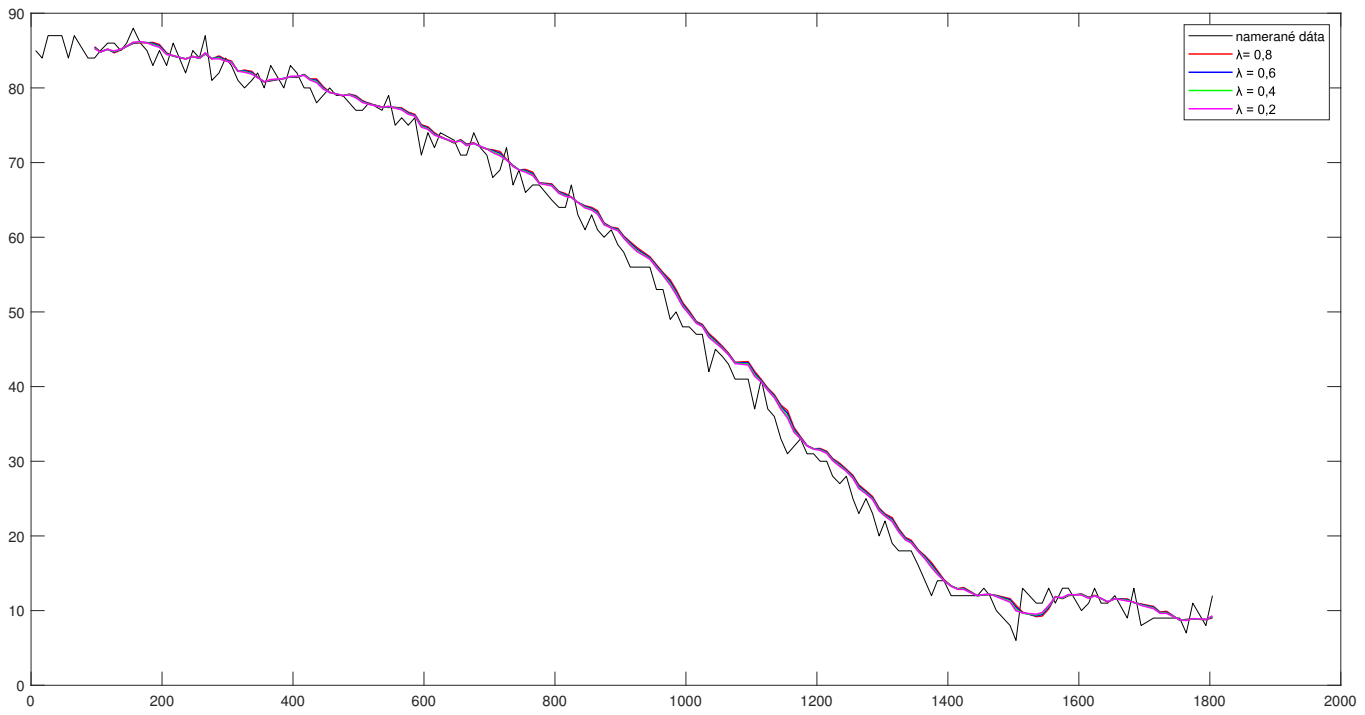
[picture p64: page 1]
namerané dáta
