MichalBiro/Bachelor-thesis/Latex/obr/SensorRead-eps-converted-to.pdf

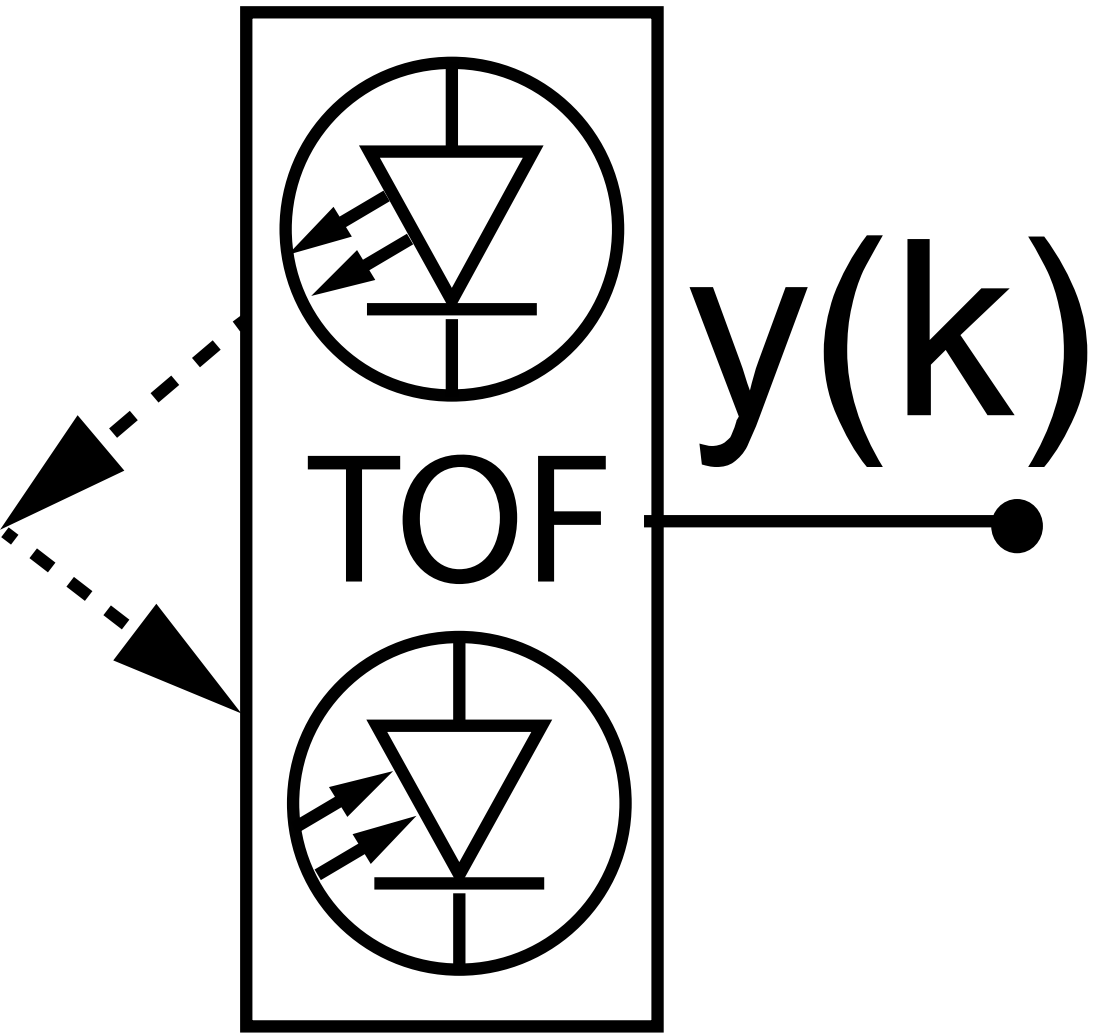
[picture p65: page 1]
