MichalBiro/Bachelor-thesis/Latex/obr/Filtracia-eps-converted-to.pdf

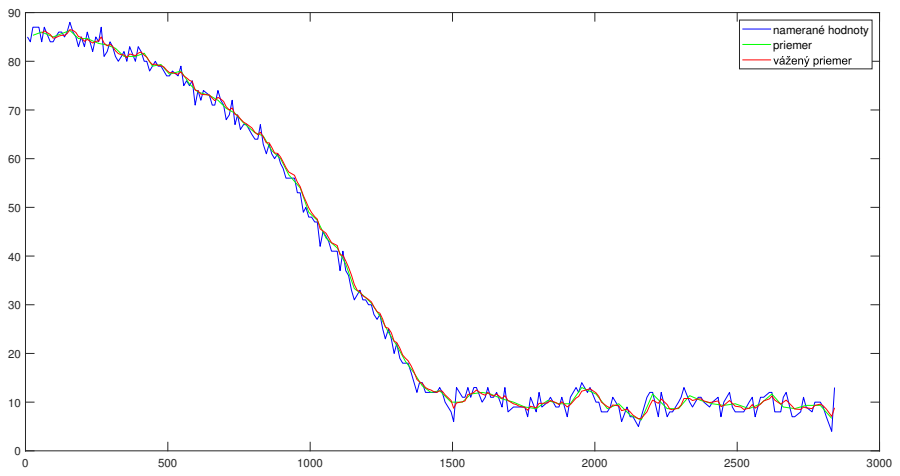
[picture p66: page 1]
namerané hodnoty priemer
