MichalBiro/Bachelor-thesis/(list of files, drawings)

Other design files:
DipTrace/BoBshield.dch
DipTrace/BoBshield.dip
DipTrace/ToF+Gyro_2.dch
DipTrace/ToF_Gyro.dip
