MichalBiro/Bachelor-thesis/(commit log)

2022-03-05 diptrace files
    [BoBshield.dch, BoBshield.dip, ToF+Gyro_2.dch, ToF_Gyro.dip]
2022-05-20 chapter 2
    [ToF+Gyro_2.dch]
2022-05-24 chapter 1 and 3
    [BoBshield.dip]
